bontango/WillFA7/docs/switch_matrix/07_Flash.md

== Flash ==

Williams ''Flash'' (1979), System 4. 48 belegte Schalter, Matrix 6 x 8.

=== Switch Matrix ===

{| class="wikitable"
!  !! Column 1<br />GRN-BRN !! Column 2<br />GRN-RED !! Column 3<br />GRN-ORN !! Column 4<br />GRN-YEL !! Column 5<br />GRN-BLK !! Column 6<br />GRN-BLU
|-
! Return 1<br />WHT-BRN
| 01 Plumb Bob Tilt || 09 Outside Upper Left Star Rollover || 17 Spinner || 25 Right Side Standup (Center) || 33 5-Bank, 2 Drop Target || 41 Left Kicker
|-
! Return 2<br />WHT-RED
| 02 Ball Roll Tilt || 10 Inside Upper Left Star Rollover || 18 Left Jet Bumper || 26 Right Side Standup (Lower) || 34 5-Bank, 3 Drop Target || 42 Right Kicker
|-
! Return 3<br />WHT-ORN
| 03 Credit Button || 11 Upper Left Standup || 19 Right Jet Bumper || 27 Eject Hole || 35 5-Bank, 4 Drop Target || 43 Left Special
|-
! Return 4<br />WHT-YEL
| 04 Right Coin Switch || 12 "1" Rollover || 20 Lower Jet Bumper || 28 3-Bank, Right Drop Target || 36 5-Bank, 5 Drop Target (Bottom) || 44 Left Flipper Return Lane Rollover
|-
! Return 5<br />WHT-GRN
| 05 Center Coin Switch || 13 "2" Rollover || 21 Upper Right Star Rollover || 29 3-Bank, Center Drop Target || 37 5-Bank Series || 45 Right Flipper Return Lane Rollover
|-
! Return 6<br />WHT-BLU
| 06 Left Coin Switch || 14 "3" Rollover || 22 Center Right Star Rollover || 30 3-Bank, Left Drop Target || 38 5-Bank Standup || 46 Right Special
|-
! Return 7<br />WHT-VIO
| 07 Slam Tilt || 15 "4" Rollover || 23 Lower Right Star Rollover || 31 3-Bank, Series || 39 Left Target || 47 Playfield Tilt
|-
! Return 8<br />WHT-GRY
| 08 High Score To Date Reset || 16 Top Right Standup || 24 Right Side Standup (Upper) || 32 5-Bank, 1 Drop Target (Top) || 40 Right Target || 48 Out Hole
|}

Columns 7 und 8 sind unbelegt (Switches 49-64).

=== Quelle ===

Schalterbelegung: Original-Handbuchblatt ''Flash'', Figure 11 "Switch Matrix". Das Blatt
deckt sich Schalter fuer Schalter mit der Pinitech-Datenbank; abweichend sind nur die
Schreibweisen (43/46 "Left/Right Special" statt "... Rollover", 44/45 mit "Lane",
48 "Out Hole"). Zusaetzlich gegengeprueft an der Dispatch-Tabelle des Spiel-ROMs
($60F1, 4 Bytes/Switch).

Kabelfarben: bei Williams System 3-7 einheitlich; belegt durch die Original-Handbuchblaetter von ''Contact'' (System 3, 1978, alle acht Spalten und Zeilen) und ''Laser Ball'' (System 6, 1979, Spalten 2-8), die identisch sind.
