bontango/WillFA7/docs/switch_matrix/08_Stellar_Wars.md

== Stellar Wars ==

Williams ''Stellar Wars'' (1979), System 4. 52 belegte Schalter, Matrix 7 x 8.

=== Switch Matrix ===

{| class="wikitable"
!  !! Column 1<br />GRN-BRN !! Column 2<br />GRN-RED !! Column 3<br />GRN-ORN !! Column 4<br />GRN-YEL !! Column 5<br />GRN-BLK !! Column 6<br />GRN-BLU !! Column 7<br />GRN-VIO
|-
! Return 1<br />WHT-BRN
| 01 Plumb Bob Tilt || 09 Outhole || 17 Left 3-Bank Center || 25 Left Spinner || 33 Right 3-Bank Right || 41 Right Special Rollover || 49 Playfield Tilt
|-
! Return 2<br />WHT-RED
| 02 Ball Roll Tilt || 10 Left Special Rollover || 18 Left 3-Bank Top || 26 "1" Rollover || 34 Right 3-Bank Series || 42 "S" Rollover || 50 4-Bank Left
|-
! Return 3<br />WHT-ORN
| 03 Credit Button || 11 "W" Rollover || 19 Left 3-Bank Series || 27 "2" Rollover || 35 Right 3-Bank Standup || 43 "R" Rollover || 51 4-Bank Left Center
|-
! Return 4<br />WHT-YEL
| 04 Right Coin Switch || 12 "A" Rollover || 20 Left 3-Bank Standup || 28 "3" Rollover || 36 Top Right Standup || 44 Right Kicker || 52 4-Bank Right Center
|-
! Return 5<br />WHT-GRN
| 05 Center Coin Switch || 13 Left Kicker || 21 Eject Hole || 29 "4" Rollover || 37 Right Spinner || 45 Top Left Jet Bumper || 53 4-Bank Right
|-
! Return 6<br />WHT-BLU
| 06 Left Coin Switch || 14 Bottom Left Jet Bumper || 22 Captive Ball Target || 30 Middle Right Standup || 38 Right Bull's-Eye Target || 46 Top Right Jet Bumper || 54 4-Bank Series
|-
! Return 7<br />WHT-VIO
| 07 Slam Tilt || 15 Not Used || 23 Lower Top Left Standup || 31 Right 3-Bank Left || 39 Not Used || 47 Bottom Right Jet Bumper || 55 Not Used
|-
! Return 8<br />WHT-GRY
| 08 High Score Reset || 16 Left 3-Bank Bottom || 24 Upper Top Left Standup || 32 Right 3-Bank Center || 40 Top Center Jet Bumper || 48 Center Standup || 56 Not Used
|}

Column 8 ist unbelegt (Switches 57-64).

=== Quelle ===

Schalterbelegung: Original-Handbuchblatt ''Stellar Wars'', Figure 11 "Switch Matrix".

Das Handbuchblatt korrigiert die Pinitech-Datenbank an einer funktional relevanten
Stelle: dort ist Switch 34 als "Top 3-Bank, Drop Target Series" **und** Switch 35
noch einmal als "Top 3-Bank Series" gefuehrt. Laut Handbuch ist 34 die Series und
35 der **Standup** der rechten 3-Bank. Damit sind beide 3-Banks symmetrisch aufgebaut:
links 16/17/18 Targets, 19 Series, 20 Standup - rechts 31/32/33 Targets, 34 Series,
35 Standup. Ausserdem heisst die Bank im Handbuch durchgaengig "Right 3-Bank", nicht
"Top 3-Bank".

Die Dispatch-Tabelle des Spiel-ROMs ($60DF, 4 Bytes/Switch) bestaetigt die Zuordnung
der Kabinettschalter 1-8 (acht verschiedene Sonder-Handler) und des Outhole 9 ($7E15);
fuer 34/35 ist sie nicht aussagekraeftig, weil in Stellar Wars fast alle
Spielfeldschalter ueber denselben Handler $7209 laufen und sich nur im Datenzeiger
unterscheiden.

Kabelfarben: bei Williams System 3-7 einheitlich; belegt durch die Original-Handbuchblaetter von ''Contact'' (System 3, 1978, alle acht Spalten und Zeilen) und ''Laser Ball'' (System 6, 1979, Spalten 2-8), die identisch sind.
