bontango/WillFA7/docs/switch_matrix/00_Hot_Tip.md

== Hot Tip ==

Williams ''Hot Tip'' (1977), System 3. 35 belegte Schalter, Matrix 5 x 8.

=== Switch Matrix ===

{| class="wikitable"
!  !! Column 1<br />GRN-BRN !! Column 2<br />GRN-RED !! Column 3<br />GRN-ORN !! Column 4<br />GRN-YEL !! Column 5<br />GRN-BLK
|-
! Return 1<br />WHT-BRN
| 01 Plumb Tilt || 09 Ball Return || 17 Right "Tip" Target || 25 Right "Hot" Target || 33 Bottom L.r.o. Special 1000
|-
! Return 2<br />WHT-RED
| 02 Ball Roll Tilt || 10 Playfield Tilt || 18 Center "Tip" Target || 26 Center "Hot" Target || 34 Inside Bottom L.r.o. 1000
|-
! Return 3<br />WHT-ORN
| 03 Credit Button || 11 Bottom R.r.o. Special 1000 || 19 Left "Tip" Target || 27 Left "Hot" Target || 35 L. Kicker 10 Pt. Sw.
|-
! Return 4<br />WHT-YEL
| 04 25 Cent Switch || 12 Inside Bottom R.r.o. 1000 || 20 Top Advance Bonus Target || 28 L. Top Stand-Up Sw. 10 || 36 Not Used
|-
! Return 5<br />WHT-GRN
| 05 10 Cent Switch || 13 R. Kicker 10 Pt. Sw. || 21 R. Top Stand-Up Sw. 10 || 29 L. Eject Sw. || 37 "Hot-Tip" Series
|-
! Return 6<br />WHT-BLU
| 06 5 Cent Switch || 14 R. Stand-Up Sw. 500 || 22 Top Eject Sw. || 30 Spinning Target Sw. || 38 Not Used
|-
! Return 7<br />WHT-VIO
| 07 Slam Tilt || 15 Captive Ball R.o. Sw. || 23 L. Top Stand-Up Sw. 10 || 31 Jet Bumper Sw. || 39 Not Used
|-
! Return 8<br />WHT-GRY
| 08 Not Used || 16 Captive Ball Target || 24 L. Top Rollover Sw. || 32 L. Stand-Up Sw. 500 || 40 Not Used
|}

=== Quelle ===

Schalterbelegung: Original-Handbuchblatt ''FIGURE 7 - SWITCH'' (Williams Electronics).

Kabelfarben: bei Williams System 3-7 einheitlich; belegt durch die Original-Handbuchblaetter von ''Contact'' (System 3, 1978, alle acht Spalten und Zeilen) und ''Laser Ball'' (System 6, 1979, Spalten 2-8), die identisch sind.
