bontango/WillFA7/docs/switch_matrix/01_Lucky_Seven.md

== Lucky Seven ==

Williams ''Lucky Seven'' (1978), System 3. 38 belegte Schalter, Matrix 7 x 8.

=== Switch Matrix ===

{| class="wikitable"
!  !! Column 1<br />GRN-BRN !! Column 2<br />GRN-RED !! Column 3<br />GRN-ORN !! Column 4<br />GRN-YEL !! Column 5<br />GRN-BLK !! Column 6<br />GRN-BLU !! Column 7<br />GRN-VIO
|-
! Return 1<br />WHT-BRN
| 01 Plumb Tilt || 09 Top Advance Bonus Target || 17 Both Drop Targets Down || 25 Not Used || 33 Left Jet Bumper || 41 Right Clover || 49 Not Used
|-
! Return 2<br />WHT-RED
| 02 Ball Roll Tilt || 10 Advance Bonus R.o. || 18 Bottom Advance Bonus Target || 26 Not Used || 34 Right Jet Bumper || 42 Not Used || 50 Center Clover
|-
! Return 3<br />WHT-ORN
| 03 Credit Button || 11 Left Reel R.o. || 19 Left Outside R.o. || 27 Left Clover || 35 Left Reel Target || 43 Not Used || 51 Not Used
|-
! Return 4<br />WHT-YEL
| 04 25 Cent Switch || 12 Center Reel R.o. || 20 Left Inside R.o. || 28 Three Sevens || 36 Right Kicker || 44 Not Used || 52 Not Used
|-
! Return 5<br />WHT-GRN
| 05 10 Cent Switch || 13 Right Reel R.o. || 21 Right Inside R.o. || 29 Three Horse-Shoes || 37 Top Left Stand Up || 45 Not Used || 53 Not Used
|-
! Return 6<br />WHT-BLU
| 06 5 Cent Switch || 14 Spinner || 22 Right Outside R.o. || 30 Three Diamonds || 38 Bottom Right Stand Up || 46 Not Used || 54 Not Used
|-
! Return 7<br />WHT-VIO
| 07 Slam Tilt || 15 Left Drop Target || 23 Outhole || 31 Playfield Tilt || 39 Center Reel Target || 47 Not Used || 55 Not Used
|-
! Return 8<br />WHT-GRY
| 08 Not Used || 16 Right Drop Target || 24 Left Kicker || 32 Not Used || 40 Right Reel Target || 48 Not Used || 56 Not Used
|}

=== Quelle ===

Schalterbelegung: Original-Handbuchblatt ''FIGURE 7 - SWITCH'' (Williams Electronics).

Kabelfarben: bei Williams System 3-7 einheitlich; belegt durch die Original-Handbuchblaetter von ''Contact'' (System 3, 1978, alle acht Spalten und Zeilen) und ''Laser Ball'' (System 6, 1979, Spalten 2-8), die identisch sind.
