bontango/WillFA7/docs/switch_matrix/02_World_Cup.md

== World Cup ==

Williams ''World Cup'' (1978), System 3. 37 belegte Schalter, Matrix 5 x 8.

=== Switch Matrix ===

{| class="wikitable"
!  !! Column 1<br />GRN-BRN !! Column 2<br />GRN-RED !! Column 3<br />GRN-ORN !! Column 4<br />GRN-YEL !! Column 5<br />GRN-BLK
|-
! Return 1<br />WHT-BRN
| 01 Plumb Tilt || 09 Left Eject || 17 Right Standup (10 Pt) || 25 Spinner || 33 Top Left Standup (10 Pt)
|-
! Return 2<br />WHT-RED
| 02 Ball Roll Tilt || 10 Left Standup (50 Pt) || 18 Right Special || 26 Super Ball Advance || 34 "S" Target
|-
! Return 3<br />WHT-ORN
| 03 Credit Button || 11 Left Special || 19 Right Standup (50 Pt) || 27 "R" Target || 35 Left Super Ball Advance
|-
! Return 4<br />WHT-YEL
| 04 25 Cent Switch || 12 Left Standup (10 Pt) || 20 Right Eject || 28 Right Super Ball Advance || 36 Left Inside Ball Advance
|-
! Return 5<br />WHT-GRN
| 05 10 Cent Switch || 13 Left Ball Thrower ("T") || 21 Ball Advance 1 || 29 Top Right Standup (10 Pt) || 37 Left Jet Bumper
|-
! Return 6<br />WHT-BLU
| 06 5 Cent Switch || 14 Outhole || 22 Ball Advance 2 || 30 Top Right Rollover (A/r) || 38 Right Jet Bumper
|-
! Return 7<br />WHT-VIO
| 07 Slam Tilt || 15 Playfield Tilt || 23 Ball Advance 3 || 31 Top Center Rollover || 39 Not Used
|-
! Return 8<br />WHT-GRY
| 08 Not Used || 16 Right Ball Thrower ("A") || 24 Ball Advance 4 || 32 Top Left Rollover (S/t) || 40 Not Used
|}

=== Quelle ===

Schalterbelegung: Original-Handbuchblatt ''WORLD CUP - SWITCH'' (Williams Electronics).

Kabelfarben: bei Williams System 3-7 einheitlich; belegt durch die Original-Handbuchblaetter von ''Contact'' (System 3, 1978, alle acht Spalten und Zeilen) und ''Laser Ball'' (System 6, 1979, Spalten 2-8), die identisch sind.
