bontango/WillFA7/docs/switch_matrix/03_Contact.md

== Contact ==

Williams ''Contact'' (1978), System 3. 39 belegte Schalter, Matrix 5 x 8.

=== Switch Matrix ===

{| class="wikitable"
!  !! Column 1<br />GRN-BRN !! Column 2<br />GRN-RED !! Column 3<br />GRN-ORN !! Column 4<br />GRN-YEL !! Column 5<br />GRN-BLK
|-
! Return 1<br />WHT-BRN
| 01 Plumb Bob Tilt || 09 "C" Rollover || 17 Right Special || 25 Left Center Standup || 33 Top Jet Bumper
|-
! Return 2<br />WHT-RED
| 02 Ball Roll Tilt || 10 "O" Eject || 18 Bottom Right Standup || 26 Left Eject || 34 Left Jet Bumper
|-
! Return 3<br />WHT-ORN
| 03 Credit Button || 11 "N" Rollover || 19 Right "T" || 27 Left Drop Target || 35 Right Jet Bumper
|-
! Return 4<br />WHT-YEL
| 04 Left Coin Switch || 12 Score Grn Value || 20 Outhole || 28 Left Center Drop Target || 36 "A" Target
|-
! Return 5<br />WHT-GRN
| 05 Center Coin Switch || 13 Top Right Target || 21 Left "T" || 29 Right Center Drop Target || 37 Moving Target
|-
! Return 6<br />WHT-BLU
| 06 Right Coin Switch || 14 Top Right Standup || 22 Bottom Left Standup || 30 Right Drop Target || 38 "C" Target
|-
! Return 7<br />WHT-VIO
| 07 Slam Tilt || 15 Bottom Right Target || 23 Left Special || 31 4 Drop Targets (Series) || 39 Inner Flipper
|-
! Return 8<br />WHT-GRY
| 08 Not Used || 16 Right Center Standup || 24 Playfield Tilt || 32 Lites Extra Ball Rollover || 40 Outer Flipper
|}

=== Quelle ===

Schalterbelegung: Original-Handbuchblatt ''Figure 9, CONTACT Switch Matrix'' (Williams Electronics).

Kabelfarben: bei Williams System 3-7 einheitlich; belegt durch die Original-Handbuchblaetter von ''Contact'' (System 3, 1978, alle acht Spalten und Zeilen) und ''Laser Ball'' (System 6, 1979, Spalten 2-8), die identisch sind.
