bontango/WillFA7/docs/switch_matrix/04_Disco_Fever.md

== Disco Fever ==

Williams ''Disco Fever'' (1978), System 3. 35 belegte Schalter, Matrix 5 x 8.

=== Switch Matrix ===

{| class="wikitable"
!  !! Column 1<br />GRN-BRN !! Column 2<br />GRN-RED !! Column 3<br />GRN-ORN !! Column 4<br />GRN-YEL !! Column 5<br />GRN-BLK
|-
! Return 1<br />WHT-BRN
| 01 Plumb Tilt || 09 Top Left Stand Up || 17 Right Jet Bumper || 25 Left Outside Rollover || 33 Left Jet Bumper
|-
! Return 2<br />WHT-RED
| 02 Ball Roll Tilt || 10 Top "A" Rollover || 18 Right Side Stand Up || 26 Spot "A" Or "B" Rollover || 34 Top Left Spot Disco
|-
! Return 3<br />WHT-ORN
| 03 Credit Button || 11 "F" Drop Target || 19 Right Outside Rollover || 27 Top "B" Rollover || 35 Turn Around Switch
|-
! Return 4<br />WHT-YEL
| 04 Left Coin Switch || 12 Top Right Stand Up || 20 "E" Drop Target || 28 Right Inside Rollover || 36 Not Used
|-
! Return 5<br />WHT-GRN
| 05 Center Coin Switch || 13 Top Right Advance Bonus || 21 Right Kicker || 29 "V" Drop Target || 37 Not Used
|-
! Return 6<br />WHT-BLU
| 06 Right Coin Switch || 14 Top Right Spot Disco || 22 Outhole || 30 Playfield Tilt || 38 "E" Drop Target
|-
! Return 7<br />WHT-VIO
| 07 Slam Tilt || 15 Bull's-Eye Target || 23 Left Kicker || 31 Not Used || 39 "R" Drop Target
|-
! Return 8<br />WHT-GRY
| 08 Not Used || 16 Mid Right Stand Up || 24 Left Inside Rollover || 32 Not Used || 40 "Er" Stand Up
|}

=== Quelle ===

Schalterbelegung: Original-Handbuchblatt ''Figure 9, DISCO FEVER Switch Matrix'' (Williams Electronics).

Kabelfarben: bei Williams System 3-7 einheitlich; belegt durch die Original-Handbuchblaetter von ''Contact'' (System 3, 1978, alle acht Spalten und Zeilen) und ''Laser Ball'' (System 6, 1979, Spalten 2-8), die identisch sind.
