bontango/WillFA7/docs/switch_matrix/09_Tri_Zone.md

== Tri Zone ==

Williams ''Tri Zone'' (1979), System 6. 35 belegte Schalter, Matrix 5 x 8.

=== Switch Matrix ===

{| class="wikitable"
!  !! Column 1<br />GRN-BRN !! Column 2<br />GRN-RED !! Column 3<br />GRN-ORN !! Column 4<br />GRN-YEL !! Column 5<br />GRN-BLK
|-
! Return 1<br />WHT-BRN
| 01 Plumb Bob Tilt || 09 Outhole || 17 Right Standup || 25 Eject Hole || 33 "N" Drop Target
|-
! Return 2<br />WHT-RED
| 02 Ball Roll Tilt || 10 Top A Rollover || 18 "R" Rollover || 26 Left Kicker || 34 Playfield Tilt
|-
! Return 3<br />WHT-ORN
| 03 Credit Button || 11 Top B Rollover || 19 "I" Rollover || 27 Left Inside Rollover || 35 "Z-O-N-E" Drop Targets Series
|-
! Return 4<br />WHT-YEL
| 04 Right Coin Switch || 12 Left Standup || 20 "E" Drop Target || 28 Left Outside Rollover || 36 Not Used
|-
! Return 5<br />WHT-GRN
| 05 Center Coin Switch || 13 Top Jet Bumper || 21 Lower Right Standup || 29 Bottom Left Standup || 37 Not Used
|-
! Return 6<br />WHT-BLU
| 06 Left Coin Switch || 14 Left Jet Bumper || 22 Right Outside Rollover || 30 "Z" Drop Target || 38 Not Used
|-
! Return 7<br />WHT-VIO
| 07 Slam Tilt || 15 Right Jet Bumper || 23 Right Inside Rollover || 31 Spinner || 39 Not Used
|-
! Return 8<br />WHT-GRY
| 08 High Score Reset || 16 "O" Drop Target || 24 Right Kicker || 32 "T" Rollover || 40 Not Used
|}

=== Quelle ===

Schalterbelegung: Pinitech Switch Matrix Database, https://www.pinitech.com/switch_database.php

Kabelfarben: bei Williams System 3-7 einheitlich; belegt durch die Original-Handbuchblaetter von ''Contact'' (System 3, 1978, alle acht Spalten und Zeilen) und ''Laser Ball'' (System 6, 1979, Spalten 2-8), die identisch sind.
