bontango/WillFA7/docs/switch_matrix/10_Time_Warp.md

== Time Warp ==

Williams ''Time Warp'' (1979), System 6. 44 belegte Schalter, Matrix 6 x 8.

=== Switch Matrix ===

{| class="wikitable"
!  !! Column 1<br />GRN-BRN !! Column 2<br />GRN-RED !! Column 3<br />GRN-ORN !! Column 4<br />GRN-YEL !! Column 5<br />GRN-BLK !! Column 6<br />GRN-BLU
|-
! Return 1<br />WHT-BRN
| 01 Plumb Bob Tilt || 09 Outhole || 17 Left Target || 25 5-Bank Drop Target #1 (Top) || 33 3-Bank Drop Target Left || 41 Right Kicker
|-
! Return 2<br />WHT-RED
| 02 Ball Roll Tilt || 10 Upper Right Standup || 18 Right Inside Rollover || 26 5-Bank Drop Target #2 || 34 3-Bank Drop Target Center || 42 Left Kicker
|-
! Return 3<br />WHT-ORN
| 03 Credit Button || 11 Upper Left Standup || 19 Left Top Jet Bumper || 27 5-Bank Drop Target #3 || 35 3-Bank Drop Target Right || 43 Playfield Tilt
|-
! Return 4<br />WHT-YEL
| 04 Right Coin Switch || 12 "A" Rollover || 20 Left Center Jet Bumper || 28 5-Bank Drop Target #4 || 36 3-Bank Drop Target Series || 44 Left Inside Rollover
|-
! Return 5<br />WHT-GRN
| 05 Center Coin Switch || 13 "B" Rollover || 21 Left Bottom Jet Bumper || 29 5-Bank Drop Target #5 (Bottom) || 37 3-Bank Standup || 45 Not Used
|-
! Return 6<br />WHT-BLU
| 06 Left Coin Switch || 14 "C" Rollover || 22 Right Center Jet Bumper || 30 5-Bank Drop Target Series || 38 Left Standup || 46 Not Used
|-
! Return 7<br />WHT-VIO
| 07 Slam Tilt || 15 Top Eject Hole || 23 Right Jet Bumper || 31 5-Bank Standup || 39 Right Outside Rollover || 47 Not Used
|-
! Return 8<br />WHT-GRY
| 08 High Score Reset || 16 Bull's-Eye Target || 24 Right Eject || 32 Right Standup || 40 Left Outside Rollover || 48 Not Used
|}

=== Quelle ===

Schalterbelegung: Pinitech Switch Matrix Database, https://www.pinitech.com/switch_database.php

Kabelfarben: bei Williams System 3-7 einheitlich; belegt durch die Original-Handbuchblaetter von ''Contact'' (System 3, 1978, alle acht Spalten und Zeilen) und ''Laser Ball'' (System 6, 1979, Spalten 2-8), die identisch sind.
