bontango/WillFA7/docs/switch_matrix/11_Gorgar.md

== Gorgar ==

Williams ''Gorgar'' (1979), System 6. 44 belegte Schalter, Matrix 6 x 8.

=== Switch Matrix ===

{| class="wikitable"
!  !! Column 1<br />GRN-BRN !! Column 2<br />GRN-RED !! Column 3<br />GRN-ORN !! Column 4<br />GRN-YEL !! Column 5<br />GRN-BLK !! Column 6<br />GRN-BLU
|-
! Return 1<br />WHT-BRN
| 01 Plumb Bob Tilt || 09 Outhole || 17 Upper Left Standup || 25 Middle Upper Standup || 33 "4" Target || 41 "G" Drop Target
|-
! Return 2<br />WHT-RED
| 02 Ball Roll Tilt || 10 Left Outside Rollover || 18 "G" Drop Target || 26 "A" Rollover || 34 Right Outside Rollover || 42 "A" Drop Target
|-
! Return 3<br />WHT-ORN
| 03 Credit Button || 11 "D" Rollover || 19 "O" Drop Target || 27 "B" Rollover || 35 "E" Rollover || 43 "R" Drop Target
|-
! Return 4<br />WHT-YEL
| 04 Right Coin Switch || 12 Left Kicker || 20 "R" Drop Target || 28 "C" Rollover || 36 Right Kicker || 44 "G-A-R" Drop Targets Series
|-
! Return 5<br />WHT-GRN
| 05 Center Coin Switch || 13 Lower Left Standup || 21 "G-O-R" Drop Targets Series || 29 Playfield Tilt || 37 Left Jet Bumper || 45 Not Used
|-
! Return 6<br />WHT-BLU
| 06 Left Coin Switch || 14 "1" Target || 22 "G-O-R" Drop Targets Standup || 30 Spinner || 38 Top Jet Bu Mper || 46 Not Used
|-
! Return 7<br />WHT-VIO
| 07 Slam Tilt || 15 Eject Hole || 23 Magnet Switch || 31 "2" Target || 39 Bottom Jet Bumper || 47 Not Used
|-
! Return 8<br />WHT-GRY
| 08 High Score Reset || 16 Middle Left Standup || 24 Middle Lower Standup || 32 "3" Target || 40 "G-A-R" Drop Targets Standup || 48 Not Used
|}

=== Quelle ===

Schalterbelegung: Pinitech Switch Matrix Database, https://www.pinitech.com/switch_database.php

Kabelfarben: bei Williams System 3-7 einheitlich; belegt durch die Original-Handbuchblaetter von ''Contact'' (System 3, 1978, alle acht Spalten und Zeilen) und ''Laser Ball'' (System 6, 1979, Spalten 2-8), die identisch sind.
