bontango/WillFA7/docs/switch_matrix/12_Laser_Ball.md

== Laser Ball ==

Williams ''Laser Ball'' (1979), System 6. 58 belegte Schalter, Matrix 8 x 8.

=== Switch Matrix ===

{| class="wikitable"
!  !! Column 1<br />GRN-BRN !! Column 2<br />GRN-RED !! Column 3<br />GRN-ORN !! Column 4<br />GRN-YEL !! Column 5<br />GRN-BLK !! Column 6<br />GRN-BLU !! Column 7<br />GRN-VIO !! Column 8<br />GRN-GRY
|-
! Return 1<br />WHT-BRN
| 01 Plumb Bob Tilt || 09 Outhole || 17 Left Spinner || 25 Lower Top Left Standup || 33 Upper Right Standup || 41 Right Shooter || 49 Playfield Tilt || 57 Star 8 Rollover
|-
! Return 2<br />WHT-RED
| 02 Ball Roll Tilt || 10 Left Shooter || 18 Bull's-Eye Target || 26 Upper Top Left Standup || 34 "B" Drop Target || 42 Right Special || 50 Star 1 Rollover || 58 Star 9 Rollover
|-
! Return 3<br />WHT-ORN
| 03 Credit Button || 11 Left Special || 19 "L" Drop Target || 27 "1" and "2" Rollover || 35 "A" Drop Target || 43 Right Inside Rollover || 51 Star 2 Rollover || 59 Star 10 Rollover
|-
! Return 4<br />WHT-YEL
| 04 Right Coin Switch || 12 Left Inside Rollover || 20 "A" Drop Target || 28 "3" and "4" Rollover || 36 "L" Drop Target || 44 Right Kicker || 52 Star 3 Rollover || 60 Not Used
|-
! Return 5<br />WHT-GRN
| 05 Center Coin Switch || 13 Left Kicker || 21 "S" Drop Target || 29 "5" and "6" Rollover || 37 "L" Drop Target (Bottom) || 45 Left Jet Bumper || 53 Star 4 Rollover || 61 Not Used
|-
! Return 6<br />WHT-BLU
| 06 Left Coin Switch || 14 Middle Left Side Standup || 22 "E" Drop Target || 30 "7" and "8" Rollover || 38 B-A-L-L Drop Target Series || 46 Right Jet Bumper || 54 Star 5 Rollover || 62 Not Used
|-
! Return 7<br />WHT-VIO
| 07 Slam Tilt || 15 Not Used || 23 "R" Drop Target || 31 "9" and "10" Rollover || 39 B-A-L-L Drop Target Standup || 47 Center Jet Bumper || 55 Star 6 Rollover || 63 Not Used
|-
! Return 8<br />WHT-GRY
| 08 High Score Reset || 16 Left Side Target || 24 L-A-S-E-R Drop Target Series || 32 Eject Hole || 40 Right Spinner || 48 "S-E-R" Drop Target Standup || 56 Star 7 Rollover || 64 Not Used
|}

=== Steckerbelegung ===

Aus dem Original-Handbuchblatt. Column 1 (Schalter 01-08) ist die Cabinet-Spalte und dort nicht dargestellt.

{| class="wikitable"
! Leitung !! Farbe !! Driver Board !! Playfield
|-
| Column 2 || GRN-RED || 2P2-8 || 8P1-1
|-
| Column 3 || GRN-ORN || 2P2-7 || 8P1-2
|-
| Column 4 || GRN-YEL || 2P2-6 || 8P1-3
|-
| Column 5 || GRN-BLK || 2P2-5 || 8P1-4
|-
| Column 6 || GRN-BLU || 2P2-3 || 8P1-5
|-
| Column 7 || GRN-VIO || 2P2-2 || 8P1-6
|-
| Column 8 || GRN-GRY || 2P2-1 || 8P1-7
|-
| Return 1 || WHT-BRN || 2P3-9 || 8J1-8
|-
| Return 2 || WHT-RED || 2P3-8 || 8J1-9
|-
| Return 3 || WHT-ORN || 2P3-7 || 8J1-10
|-
| Return 4 || WHT-YEL || 2P3-6 || 8J1-11
|-
| Return 5 || WHT-GRN || 2P3-5 || 8J1-12
|-
| Return 6 || WHT-BLU || 2P3-4 || 8J1-13
|-
| Return 7 || WHT-VIO || 2P3-3 || 8J1-14
|-
| Return 8 || WHT-GRY || 2P3-1 || 8J1-15
|}

=== Quelle ===

Schalterbelegung: Original-Handbuchblatt ''LASER BALL - Playfield Switch Wiring Diagram'' (Williams Electronics).

'''Hinweis:''' Das Blatt zeigt nur die Playfield-Spalten (Column 2-8, Schalter 09-59). Die Cabinet-Spalte (Column 1, Schalter 01-08) ist dort nicht enthalten und wurde nach der bei Williams System 3-7 einheitlichen Belegung ergaenzt - bitte vor der Uebernahme gegen ein Handbuch pruefen.

Kabelfarben: bei Williams System 3-7 einheitlich; belegt durch die Original-Handbuchblaetter von ''Contact'' (System 3, 1978, alle acht Spalten und Zeilen) und ''Laser Ball'' (System 6, 1979, Spalten 2-8), die identisch sind.
