bontango/WillFA7/docs/switch_matrix/13_Firepower.md

== Firepower ==

Williams ''Firepower'' (1980), System 6. 53 belegte Schalter, Matrix 8 x 8.

=== Switch Matrix ===

{| class="wikitable"
!  !! Column 1<br />GRN-BRN !! Column 2<br />GRN-RED !! Column 3<br />GRN-ORN !! Column 4<br />GRN-YEL !! Column 5<br />GRN-BLK !! Column 6<br />GRN-BLU !! Column 7<br />GRN-VIO !! Column 8<br />GRN-GRY
|-
! Return 1<br />WHT-BRN
| 01 Plumb Bob Tilt || 09 Outhole || 17 "1" Target || 25 Bottom Left Jet Bumper || 33 "I" Rollover || 41 Bottom "Power" Targets || 49 Center Middle Left Standup || 57 Right Ball Ramp
|-
! Return 2<br />WHT-RED
| 02 Ball Roll Tilt || 10 Left Outside Rollover || 18 "2" Target || 26 Top Left Jet Bumper || 34 "R" Rollover || 42 Right Kicker || 50 Lower Middle Left Standup || 58 Center Ball Ramp
|-
! Return 3<br />WHT-ORN
| 03 Credit Button || 11 Left Inside Rollover || 19 "3" Target || 27 Top Right Jet Bumper || 35 "E" Rollover || 43 Right Inside Rollover || 51 Left Ball Ramp || 59 Not Used
|-
! Return 4<br />WHT-YEL
| 04 Right Coin Switch || 12 Left Kicker || 20 Not Used || 28 Bottom Right Jet Bumper || 36 Upper Right Eject Hole || 44 Right Outside Rollover || 52 Not Used || 60 Not Used
|-
! Return 5<br />WHT-GRN
| 05 Center Coin Switch || 13 Left Eject Hole || 21 "4" Target || 29 Top Center Target || 37 Lower Top Right Standup || 45 Right Flipper Lane Change Switch || 53 Left Eject Rollover || 61 Not Used
|-
! Return 6<br />WHT-BLU
| 06 Left Coin Switch || 14 Upper Middle Left Standup || 22 "5" Target || 30 Right Eject Hole || 38 Middle Right Standup || 46 Ball Shooter || 54 Right Eject Rollover || 62 Not Used
|-
! Return 7<br />WHT-VIO
| 07 Slam Tilt || 15 Spinner || 23 "6" Target || 31 Upper Top Right Standup || 39 Top "Power" Target || 47 Playfield Tilt || 55 Not Used || 63 Not Used
|-
! Return 8<br />WHT-GRY
| 08 High Score Reset || 16 Top Left Standup || 24 Not Used || 32 "F" Rollover || 40 Middle "Power" Target || 48 Lower Right Standup || 56 Not Used || 64 Not Used
|}

=== Quelle ===

Schalterbelegung: Pinitech Switch Matrix Database, https://www.pinitech.com/switch_database.php

Kabelfarben: bei Williams System 3-7 einheitlich; belegt durch die Original-Handbuchblaetter von ''Contact'' (System 3, 1978, alle acht Spalten und Zeilen) und ''Laser Ball'' (System 6, 1979, Spalten 2-8), die identisch sind.
