bontango/WillFA7/docs/switch_matrix/14_Blackout.md

== Blackout ==

Williams ''Blackout'' (1980), System 6. 43 belegte Schalter, Matrix 6 x 8.

=== Switch Matrix ===

{| class="wikitable"
!  !! Column 1<br />GRN-BRN !! Column 2<br />GRN-RED !! Column 3<br />GRN-ORN !! Column 4<br />GRN-YEL !! Column 5<br />GRN-BLK !! Column 6<br />GRN-BLU
|-
! Return 1<br />WHT-BRN
| 01 Plumb Bob Tilt || 09 Outhole || 17 Not Used || 25 Center 3 Bank Left || 33 Top 3 Bank Left || 41 Right Outside Rollover
|-
! Return 2<br />WHT-RED
| 02 Ball Roll Tilt || 10 Left Outside Rollover || 18 Left Spinner || 26 Center 3 Bank Center || 34 Top 3 Bank Center || 42 Right Inside Rollover
|-
! Return 3<br />WHT-ORN
| 03 Credit Button || 11 Green Target #1 Bottom || 19 Left Spinner Standup || 27 Center 3 Bank Right || 35 Top 3 Bank Right || 43 Right Kicker
|-
! Return 4<br />WHT-YEL
| 04 Right Coin Switch || 12 Green Target #2 || 20 Upper Left Target || 28 Center 3 Bank Series || 36 Top 3 Bank Series || 44 Left Kicker
|-
! Return 5<br />WHT-GRN
| 05 Center Coin Switch || 13 Green Target #3 || 21 Right Jet Bumper || 29 1 Rollover || 37 Upper Right Spinner || 45 Left Inside Rollover
|-
! Return 6<br />WHT-BLU
| 06 Left Coin Switch || 14 Green Target #4 || 22 Left Jet Bumper || 30 2 Rollover || 38 Middle Right Standup || 46 Right Flipper Lane Change Switch
|-
! Return 7<br />WHT-VIO
| 07 Slam Tilt || 15 Green Target #5 Top || 23 Bottom Jet Bumper || 31 3 Rollover || 39 Middle Right Spinner || 47 Not Used
|-
! Return 8<br />WHT-GRY
| 08 High Score Reset || 16 Not Used || 24 Not Used || 32 Playfield Tilt || 40 Eject Hole || 48 Not Used
|}

=== Quelle ===

Schalterbelegung: Pinitech Switch Matrix Database, https://www.pinitech.com/switch_database.php

Kabelfarben: bei Williams System 3-7 einheitlich; belegt durch die Original-Handbuchblaetter von ''Contact'' (System 3, 1978, alle acht Spalten und Zeilen) und ''Laser Ball'' (System 6, 1979, Spalten 2-8), die identisch sind.
