bontango/WillFA7/docs/switch_matrix/15_Scorpion.md

== Scorpion ==

Williams ''Scorpion'' (1980), System 6. 57 belegte Schalter, Matrix 8 x 8.

=== Switch Matrix ===

{| class="wikitable"
!  !! Column 1<br />GRN-BRN !! Column 2<br />GRN-RED !! Column 3<br />GRN-ORN !! Column 4<br />GRN-YEL !! Column 5<br />GRN-BLK !! Column 6<br />GRN-BLU !! Column 7<br />GRN-VIO !! Column 8<br />GRN-GRY
|-
! Return 1<br />WHT-BRN
| 01 Plumb Bob Tilt || 09 Ball Ramp Thrower || 17 Right Flipper Lane Change Switch || 25 Top Left 3-Bank, Left Drop Target || 33 5-Bank #1 Drop Target (Left) || 41 Advance Left Lower Bull's-Eye Target || 49 Upper Right Return Lane || 57 Lower Right Standup
|-
! Return 2<br />WHT-RED
| 02 Ball Roll Tilt || 10 Ball Ramp || 18 Left Center Rollover || 26 Top Left 3-Bank, Center Drop Target || 34 5-Bank #2 Drop Target || 42 Advance Right Lower Bull's-Eye Target || 50 Upper Left Flipper Standup || 58 Not Used
|-
! Return 3<br />WHT-ORN
| 03 Credit Button || 11 Left Eject Hole || 19 Left Inside Rollover || 27 Top Left 3-Bank, Right Drop Target || 35 5-Bank #3 Drop Target || 43 "1" Target || 51 Top Left 3-Bank Standup || 59 Not Used
|-
! Return 4<br />WHT-YEL
| 04 Right Coin Switch || 12 Right Eject Hole || 20 Right Inside Rollover || 28 Top Right 3-Bank, Left Drop Target || 36 5-Bank #4 Drop Target || 44 "2" Target || 52 Top Right 3-Bank Standup || 60 Not Used
|-
! Return 5<br />WHT-GRN
| 05 Center Coin Switch || 13 Playfield Tilt || 21 Right Center Rollover || 29 Top Right 3-Bank, Center Drop Target || 37 5-Bank #5 Drop Target (Right) || 45 "3" Target || 53 Lower Top Center Standup || 61 Not Used
|-
! Return 6<br />WHT-BLU
| 06 Left Coin Switch || 14 Left Outside Rollover || 22 Right Jet Bumper || 30 Top Right 3-Bank, Right Drop Target || 38 5-Bank Drop Targets Series || 46 "4" Rollover || 54 5-Bank Standup || 62 Not Used
|-
! Return 7<br />WHT-VIO
| 07 Slam Switch || 15 Right Outside Rollover || 23 Bottom Jet Bumper || 31 Top 3-Banks Drop Target Series || 39 Left Kicker || 47 "5" Rollover || 55 Upper Top Center Standup || 63 Not Used
|-
! Return 8<br />WHT-GRY
| 08 High Score Reset || 16 Outhole || 24 Top Jet Bumper || 32 Spinner || 40 Right Kicker || 48 "6" Rollover || 56 Top Right Standup || 64 Not Used
|}

=== Quelle ===

Schalterbelegung: Original-Handbuchblatt ''Figure 5, Switch Matrix'' (Williams Electronics).

Kabelfarben: bei Williams System 3-7 einheitlich; belegt durch die Original-Handbuchblaetter von ''Contact'' (System 3, 1978, alle acht Spalten und Zeilen) und ''Laser Ball'' (System 6, 1979, Spalten 2-8), die identisch sind.
