bontango/WillFA7/docs/switch_matrix/16_Algar.md

== Algar ==

Williams ''Algar'' (1980), System 6A. 53 belegte Schalter, Matrix 7 x 8.

=== Switch Matrix ===

{| class="wikitable"
!  !! Column 1<br />GRN-BRN !! Column 2<br />GRN-RED !! Column 3<br />GRN-ORN !! Column 4<br />GRN-YEL !! Column 5<br />GRN-BLK !! Column 6<br />GRN-BLU !! Column 7<br />GRN-VIO
|-
! Return 1<br />WHT-BRN
| 01 Plumb Bob Tilt || 09 Outhole || 17 Left 3-Bank Drop Target Series || 25 "O" Rollover || 33 Right Chamber Target || 41 Center 3-Bank, Right Target || 49 Right Jet Bumper
|-
! Return 2<br />WHT-RED
| 02 Ball Roll Tilt || 10 Left Kicker || 18 Left 3-Bank Standup || 26 Eject Hole || 34 Middle Right Standup || 42 Center 3-Bank, Drop Target Series || 50 Right Flipper Lane Change Feature
|-
! Return 3<br />WHT-ORN
| 03 Credit Button || 11 Left Inside Rollover || 19 Ball Shooter || 27 "R" Rollover || 35 Right Return Gate Rollover || 43 Center 3-Bank Standup || 51 Playfield Tilt
|-
! Return 4<br />WHT-YEL
| 04 Right Coin Switch || 12 Left Outlane || 20 Upper Left Standup, Lower || 28 "A" Rollover || 36 Right Outside Kicker || 44 Loop Gate || 52 Upper Right Center Standup
|-
! Return 5<br />WHT-GRN
| 05 Center Coin Switch || 13 Left Loop Lane Rollover || 21 Upper Left Standup, Upper || 29 Right Spinner || 37 Right Outlane || 45 Center Left Standup || 53 Upper Right Lower Standup
|-
! Return 6<br />WHT-BLU
| 06 Left Coin Switch || 14 Left 3-Bank, Left Drop Target || 22 Left Spinner || 30 Upper Right Standup, Top || 38 Right Inside Kicker || 46 Center Right Standup || 54 Not Used
|-
! Return 7<br />WHT-VIO
| 07 Slam Tilt || 15 Left 3-Bank, Center Drop Target || 23 Top Left Standup || 31 Left Chamber Target || 39 Center 3-Bank, Left Target || 47 Left Jet Bumper || 55 Not Used
|-
! Return 8<br />WHT-GRY
| 08 High Score Reset || 16 Left 3-Bank, Right Drop Target || 24 "K" Rollover || 32 Center Chamber Target || 40 Center 3-Bank, Center Target || 48 Center Jet Bumper || 56 Not Used
|}

=== Quelle ===

Schalterbelegung: Pinitech Switch Matrix Database, https://www.pinitech.com/switch_database.php

Kabelfarben: bei Williams System 3-7 einheitlich; belegt durch die Original-Handbuchblaetter von ''Contact'' (System 3, 1978, alle acht Spalten und Zeilen) und ''Laser Ball'' (System 6, 1979, Spalten 2-8), die identisch sind.
