bontango/WillFA7/docs/switch_matrix/17_Alien_Poker.md

== Alien Poker ==

Williams ''Alien Poker'' (1980), System 6A. 43 belegte Schalter, Matrix 6 x 8.

=== Switch Matrix ===

{| class="wikitable"
!  !! Column 1<br />GRN-BRN !! Column 2<br />GRN-RED !! Column 3<br />GRN-ORN !! Column 4<br />GRN-YEL !! Column 5<br />GRN-BLK !! Column 6<br />GRN-BLU
|-
! Return 1<br />WHT-BRN
| 01 Plumb Bob Tilt || 09 Outhole || 17 Spinner || 25 King of Diamonds Rollover || 33 Lower Right Standup || 41 5 Bank Standup
|-
! Return 2<br />WHT-RED
| 02 Ball Roll Tilt || 10 "A" Drop Target || 18 "K" Drop Target || 26 "Q" Drop Target || 34 "J" Drop Target || 42 "10" Drop Target
|-
! Return 3<br />WHT-ORN
| 03 Credit Button || 11 Left Special || 19 Lower Top Standup || 27 King of Spades Rollover || 35 Center Jet Bumper || 43 Right Flipper Lane Change Switch
|-
! Return 4<br />WHT-YEL
| 04 Right Coin Switch || 12 Left Inside Rollover || 20 Top Joker Target || 28 Top Right Standup || 36 Left Jet Bumper || 44 Not Used
|-
! Return 5<br />WHT-GRN
| 05 Center Coin Switch || 13 Left Kicker || 21 Top Standup || 29 Heart Ace Eject Hole || 37 Right Jet Bumper || 45 Not Used
|-
! Return 6<br />WHT-BLU
| 06 Left Coin Switch || 14 Lower Left Joker Target || 22 Club Ace Eject Hole || 30 Right Joker Target || 38 Bottom Jet Bumper || 46 Not Used
|-
! Return 7<br />WHT-VIO
| 07 Slam Tilt || 15 Spade Ace Eject Hole || 23 King of Hearts Rollover || 31 Playfield Tilt || 39 Left Center Standup || 47 Not Used
|-
! Return 8<br />WHT-GRY
| 08 High Score Reset || 16 Middle Left Joker Target || 24 King of Clubs Rollover || 32 Right Special || 40 Right Center Standup || 48 Not Used
|}

=== Quelle ===

Schalterbelegung: Pinitech Switch Matrix Database, https://www.pinitech.com/switch_database.php

Kabelfarben: bei Williams System 3-7 einheitlich; belegt durch die Original-Handbuchblaetter von ''Contact'' (System 3, 1978, alle acht Spalten und Zeilen) und ''Laser Ball'' (System 6, 1979, Spalten 2-8), die identisch sind.
