bontango/WillFA7/docs/switch_matrix/18_Black_Knight.md

== Black Knight ==

Williams ''Black Knight'' (1980), System 7. 43 belegte Schalter, Matrix 6 x 8.

=== Switch Matrix ===

{| class="wikitable"
!  !! Column 1<br />GRN-BRN !! Column 2<br />GRN-RED !! Column 3<br />GRN-ORN !! Column 4<br />GRN-YEL !! Column 5<br />GRN-BLK !! Column 6<br />GRN-BLU
|-
! Return 1<br />WHT-BRN
| 01 Plumb Bob Tilt || 09 Right Magnet Button || 17 Right Ball Ramp || 25 Lower Left 3-Bank, Lower Target || 33 Top Left 3-Bank, Lower Target || 41 Lockup Trough, Bottom
|-
! Return 2<br />WHT-RED
| 02 Ball Roll Tilt || 10 Left Magnet Button || 18 Center Ball Ramp || 26 Lower Left 3-Bank, Center Target || 34 Top Left 3-Bank, Center Target || 42 Lockup Trough, Center
|-
! Return 3<br />WHT-ORN
| 03 Credit Button || 11 Left Outlane || 19 Left Ball Ramp || 27 Lower Left 3-Bank, Upper Target || 35 Top Left 3-Bank, Upper Target || 43 Lockup Trough, Top
|-
! Return 4<br />WHT-YEL
| 04 Right Coin Switch || 12 Right Outlane || 20 Outhole || 28 Not Used || 36 Jet Bumper || 44 Left Ramp Rollover
|-
! Return 5<br />WHT-GRN
| 05 Center Coin Switch || 13 Spinner || 21 Left Kicker || 29 Lower Right 3-Bank, Right Target || 37 Top Right 3-Bank, Lower Target || 45 Ballshooter Trough
|-
! Return 6<br />WHT-BLU
| 06 Left Coin Switch || 14 Right Ramp Rollunder || 22 Right Kicker || 30 Lower Right 3-Bank, Center Target || 38 Top Right 3-Bank, Center Target || 46 Playfield Tilt
|-
! Return 7<br />WHT-VIO
| 07 Slam Tilt || 15 Right Inside Rollover || 23 Turnaround || 31 Lower Right 3-Bank, Left Target || 39 Top Right 3-Bank, Upper Target || 47 Not Used
|-
! Return 8<br />WHT-GRY
| 08 High Score Reset || 16 Left Inside Rollover || 24 Lower Playfield Eject Hole || 32 Not Used || 40 Not Used || 48 Not Used
|}

=== Quelle ===

Schalterbelegung: Pinitech Switch Matrix Database, https://www.pinitech.com/switch_database.php

Kabelfarben: bei Williams System 3-7 einheitlich; belegt durch die Original-Handbuchblaetter von ''Contact'' (System 3, 1978, alle acht Spalten und Zeilen) und ''Laser Ball'' (System 6, 1979, Spalten 2-8), die identisch sind.
