bontango/WillFA7/docs/switch_matrix/19_Jungle_Lord.md

== Jungle Lord ==

Williams ''Jungle Lord'' (1981), System 7. 48 belegte Schalter, Matrix 7 x 8.

=== Switch Matrix ===

{| class="wikitable"
!  !! Column 1<br />GRN-BRN !! Column 2<br />GRN-RED !! Column 3<br />GRN-ORN !! Column 4<br />GRN-YEL !! Column 5<br />GRN-BLK !! Column 6<br />GRN-BLU !! Column 7<br />GRN-VIO
|-
! Return 1<br />WHT-BRN
| 01 Plumb Bob Tilt || 09 Right Ball Ramp || 17 1 Target || 25 Right 3-Bank, Lower Drop Target || 33 5-Bank, #1 Drop Target (Left) || 41 Playfield Tilt || 49 Right Magnet Button
|-
! Return 2<br />WHT-RED
| 02 Ball Roll Tilt || 10 Left Ball Ramp || 18 2 Target || 26 Right 3-Bank, Center Drop Target || 34 5-Bank, #2 Drop Target || 42 Outhole || 50 Left Magnet Button
|-
! Return 3<br />WHT-ORN
| 03 Credit Button || 11 Not Used || 19 3 Target || 27 Right 3-Bank, Upper Drop Target || 35 5-Bank, #3 Drop Target || 43 Ballshooter Trough || 51 Not Used
|-
! Return 4<br />WHT-YEL
| 04 Right Coin Switch || 12 Left Kicker || 20 4 Rollover || 28 Right Kicker || 36 5-Bank, #4 Drop Target || 44 Playfield Entry || 52 Not Used
|-
! Return 5<br />WHT-GRN
| 05 Center Coin Switch || 13 "L" Rollover || 21 5 Rollover || 29 Left 3-Bank, Lower Drop Target || 37 5-Bank, #5 Drop Target || 45 Upper Left Standup || 53 Not Used
|-
! Return 6<br />WHT-BLU
| 06 Left Coin Switch || 14 "O" Rollover || 22 Left Drain Lane || 30 Left 3-Bank, Center Drop Target || 38 Upper Eject Hole || 46 Left Standup || 54 Not Used
|-
! Return 7<br />WHT-VIO
| 07 Slam Tilt || 15 "R" Rollover || 23 Right Drain Lane || 31 Left 3-Bank, Upper Drop Target || 39 Lower Eject Hole || 47 Right Standup || 55 Not Used
|-
! Return 8<br />WHT-GRY
| 08 High Score Reset || 16 "D" Rollover || 24 Turnaround, Lower Rollover || 32 Turnaround, Upper Rollover || 40 Upper Kicker || 48 Not Used || 56 Not Used
|}

=== Quelle ===

Schalterbelegung: Pinitech Switch Matrix Database, https://www.pinitech.com/switch_database.php

Kabelfarben: bei Williams System 3-7 einheitlich; belegt durch die Original-Handbuchblaetter von ''Contact'' (System 3, 1978, alle acht Spalten und Zeilen) und ''Laser Ball'' (System 6, 1979, Spalten 2-8), die identisch sind.
