bontango/WillFA7/docs/switch_matrix/20_Pharaoh.md

== Pharaoh ==

Williams ''Pharaoh'' (1981), System 7. 41 belegte Schalter, Matrix 6 x 8.

=== Switch Matrix ===

{| class="wikitable"
!  !! Column 1<br />GRN-BRN !! Column 2<br />GRN-RED !! Column 3<br />GRN-ORN !! Column 4<br />GRN-YEL !! Column 5<br />GRN-BLK !! Column 6<br />GRN-BLU
|-
! Return 1<br />WHT-BRN
| 01 Plumb Bob Tilt || 09 Left Magnet Button || 17 Upper Left 3-Bank, Bottom Target || 25 Lower Center 3-Bank, Bottom Target || 33 Slaves Tomb Shooter || 41 Captive Ball
|-
! Return 2<br />WHT-RED
| 02 Ball Roll Tilt || 10 Right Magnet Button || 18 Upper Left 3-Bank, Center Target || 26 Lower Center 3-Bank, Center Target || 34 Upper Eject Hole || 42 Playfield Tilt
|-
! Return 3<br />WHT-ORN
| 03 Credit Button || 11 Not Used || 19 Upper Left 3-Bank, Top Target || 27 Lower Center 3-Bank, Top Target || 35 Lower Eject Hole || 43 Hidden Tomb Shooter
|-
! Return 4<br />WHT-YEL
| 04 Right Coin Switch || 12 Not Used || 20 Upper Kicker || 28 Upper Bull's-Eye Target || 36 Outhole || 44 Right Kicker
|-
! Return 5<br />WHT-GRN
| 05 Center Coin Switch || 13 Left Inside Rollover || 21 Upper Center 3-Bank, Left Target || 29 Lower Right 3-Bank, Top Target || 37 Not Used || 45 Not Used
|-
! Return 6<br />WHT-BLU
| 06 Left Coin Switch || 14 Right Inside Rollover || 22 Upper Center 3-Bank, Center Target || 30 Lower Right 3-Bank, Center Target || 38 Ball Ramp Left Switch || 46 Not Used
|-
! Return 7<br />WHT-VIO
| 07 Slam Tilt || 15 Left ? Lane Rollover || 23 Upper Center 3-Bank, Right Target || 31 Lower Right 3-Bank, Bottom Target || 39 Ball Ramp Right Switch || 47 Not Used
|-
! Return 8<br />WHT-GRY
| 08 High Score Reset || 16 Right ? Lane Rollover || 24 Left Kicker || 32 Lower Bull's-Eye Target || 40 Ballshooter Trough || 48 Not Used
|}

=== Quelle ===

Schalterbelegung: Pinitech Switch Matrix Database, https://www.pinitech.com/switch_database.php

Kabelfarben: bei Williams System 3-7 einheitlich; belegt durch die Original-Handbuchblaetter von ''Contact'' (System 3, 1978, alle acht Spalten und Zeilen) und ''Laser Ball'' (System 6, 1979, Spalten 2-8), die identisch sind.
