bontango/WillFA7/docs/switch_matrix/21_Solar_Fire.md

== Solar Fire ==

Williams ''Solar Fire'' (1981), System 7. 43 belegte Schalter, Matrix 6 x 8.

=== Switch Matrix ===

{| class="wikitable"
!  !! Column 1<br />GRN-BRN !! Column 2<br />GRN-RED !! Column 3<br />GRN-ORN !! Column 4<br />GRN-YEL !! Column 5<br />GRN-BLK !! Column 6<br />GRN-BLU
|-
! Return 1<br />WHT-BRN
| 01 Plumb Bob Tilt || 09 Left Magnet Button || 17 Top Eject Hole || 25 Right Bull's-Eye Target || 33 Top 3-Bank, Bottom Target || 41 Solar Ramp Target
|-
! Return 2<br />WHT-RED
| 02 Ball Roll Tilt || 10 Right Magnet Button || 18 Bottom Right Eject Hole || 26 Right Ramp Rollunder || 34 Top 3-Bank, Middle Target || 42 Solar Gun
|-
! Return 3<br />WHT-ORN
| 03 Credit Button || 11 Left Kicker || 19 Bottom Left Eject Hole || 27 Bottom Left 3-Bank, Bottom Target || 35 Top 3-Bank, Top Target || 43 Playfield Tilt
|-
! Return 4<br />WHT-YEL
| 04 Right Coin Switch || 12 Right Kicker || 20 Outhole || 28 Bottom Left 3-Bank, Middle Target || 36 4-Bank "1" (Left) Target || 44 Not Used
|-
! Return 5<br />WHT-GRN
| 05 Center Coin Switch || 13 Left Outlane || 21 Ball Ramp Right Switch || 29 Bottom Left 3-Bank, Top Target || 37 4-Bank "2" Target || 45 Not Used
|-
! Return 6<br />WHT-BLU
| 06 Left Coin Switch || 14 Right Outlane || 22 Ball Ramp Center Switch || 30 Bottom Right 3-Bank, Top Target || 38 4-Bank "3" Target || 46 Not Used
|-
! Return 7<br />WHT-VIO
| 07 Slam Tilt || 15 Left Inside Rollover || 23 Ball Ramp Left Switch || 31 Bottom Right 3-Bank, Middle Target || 39 4-Bank "4" (Right) Target || 47 Not Used
|-
! Return 8<br />WHT-GRY
| 08 High Score Reset || 16 Right Inside Rollover || 24 Ballshooter Trough || 32 Bottom Right 3-Bank, Bottom Target || 40 Horseshoe Rollover || 48 Not Used
|}

=== Quelle ===

Schalterbelegung: Pinitech Switch Matrix Database, https://www.pinitech.com/switch_database.php

Kabelfarben: bei Williams System 3-7 einheitlich; belegt durch die Original-Handbuchblaetter von ''Contact'' (System 3, 1978, alle acht Spalten und Zeilen) und ''Laser Ball'' (System 6, 1979, Spalten 2-8), die identisch sind.
