bontango/WillFA7/docs/switch_matrix/22_Barracora.md

== Barracora ==

Williams ''Barracora'' (1981), System 7. 48 belegte Schalter, Matrix 6 x 8.

=== Switch Matrix ===

{| class="wikitable"
!  !! Column 1<br />GRN-BRN !! Column 2<br />GRN-RED !! Column 3<br />GRN-ORN !! Column 4<br />GRN-YEL !! Column 5<br />GRN-BLK !! Column 6<br />GRN-BLU
|-
! Return 1<br />WHT-BRN
| 01 Plumb Bob Tilt || 09 "Barracora" Lane Rollover || 17 1/4 Lane Rollover || 25 Spinner Target || 33 Upper Right Bull's-Eye Target || 41 B Drop Target
|-
! Return 2<br />WHT-RED
| 02 Ball Roll Tilt || 10 Upper Eject Hole || 18 2/5 Lane Rollover || 26 Right Turnaround || 34 Left Flipper Lane Change Switch || 42 A Drop Target
|-
! Return 3<br />WHT-ORN
| 03 Credit Button || 11 Lower Eject Hole || 19 3/6 Lane Rollover || 27 Left Bull's-Eye Target || 35 Right Flipper Lane Change Switch || 43 Rr Drop Target
|-
! Return 4<br />WHT-YEL
| 04 Right Coin Switch || 12 Outhole || 20 Left Jet Bumper || 28 Right Bull's-Eye Target || 36 Playfield Tilt || 44 A Drop Target
|-
! Return 5<br />WHT-GRN
| 05 Center Coin Switch || 13 Left Ball Ramp Switch || 21 Right Jet Bumpe || 29 Left Kicker || 37 Upper Right Standup || 45 C Drop Target
|-
! Return 6<br />WHT-BLU
| 06 Left Coin Switch || 14 Center Ball Ramp Switch || 22 Bottom Jet Bumper || 30 Right Kicker || 38 Lower Standup || 46 O Drop Target
|-
! Return 7<br />WHT-VIO
| 07 Slam Tilt || 15 Right Ball Ramp Switch || 23 Left Outside Rollover || 31 Left Inside Rollover || 39 5-Bank Standup || 47 R Drop Target
|-
! Return 8<br />WHT-GRY
| 08 High Score Reset || 16 Ball Shooter Trough Rollover || 24 Right Outside Rollover || 32 Right Inside Rollover || 40 Lower Left Standup || 48 A Drop Target
|}

=== Quelle ===

Schalterbelegung: Pinitech Switch Matrix Database, https://www.pinitech.com/switch_database.php

Kabelfarben: bei Williams System 3-7 einheitlich; belegt durch die Original-Handbuchblaetter von ''Contact'' (System 3, 1978, alle acht Spalten und Zeilen) und ''Laser Ball'' (System 6, 1979, Spalten 2-8), die identisch sind.
