bontango/WillFA7/docs/switch_matrix/23_Cosmic_Gunfight.md

== Cosmic Gunfight ==

Williams ''Cosmic Gunfight'' (1981), System 7. 51 belegte Schalter, Matrix 7 x 8.

=== Switch Matrix ===

{| class="wikitable"
!  !! Column 1<br />GRN-BRN !! Column 2<br />GRN-RED !! Column 3<br />GRN-ORN !! Column 4<br />GRN-YEL !! Column 5<br />GRN-BLK !! Column 6<br />GRN-BLU !! Column 7<br />GRN-VIO
|-
! Return 1<br />WHT-BRN
| 01 Plumb Bob Tilt || 09 X Rollover || 17 Not Used || 25 Top Eject Hole || 33 A-B-C Left Standup Target || 41 Left 3-Bank Center Drop Target || 49 Right Flipper Lane Change Switch
|-
! Return 2<br />WHT-RED
| 02 Ball Roll Tilt || 10 Y Rollover || 18 Right 3-Bank Standup || 26 Lower Eject Hole || 34 A-B-C Center Standup Target || 42 Left 3-Bank Top Drop Target || 50 Top Center Standup
|-
! Return 3<br />WHT-ORN
| 03 Credit Button || 11 Lane 1 Rollover || 19 Lower Right Standup || 27 Right Ball Ramp Switch || 35 A-B-C Right Standup Target || 43 Center 3-Bank Left Drop Target || 51 Ball Shooter Rollover
|-
! Return 4<br />WHT-YEL
| 04 Right Coin Chute || 12 Lane 2 Rollover || 20 Lower Left Standup || 28 Left Ball Ramp Switch || 36 Left Kicker || 44 Center 3-Bank Center Drop Target || 52 Left Flipper Lane Change Switch
|-
! Return 5<br />WHT-GRN
| 05 Center Coin Chute || 13 Lane 3 Rollover || 21 Left Jet Bumper || 29 Outhole || 37 Right Kicker || 45 Center 3-Bank Right Drop Target || 53 Not Used
|-
! Return 6<br />WHT-BLU
| 06 Left Coin Chute || 14 Top Right Side Lane Rollover || 22 Center Jet Bumper || 30 Playfield Tilt || 38 Left Flipper Lane Rollover || 46 Right 3-Bank Bottom Drop Target || 54 Not Used
|-
! Return 7<br />WHT-VIO
| 07 Slam Tilt || 15 Top Left Standup || 23 Right Jet Bumper || 31 Outer Left Drain Lane Rollover || 39 Right Flipper Lane Rollover || 47 Right 3-Bank Center Drop Target || 55 Not Used
|-
! Return 8<br />WHT-GRY
| 08 High Score Reset || 16 Top Right Standup || 24 Bottom Jet Bumper || 32 Outer Right Drain Lane Rollover || 40 Left 3-Bank Bottom Drop Target || 48 Right 3-Bank Top Drop Target || 56 Not Used
|}

=== Quelle ===

Schalterbelegung: Pinitech Switch Matrix Database, https://www.pinitech.com/switch_database.php

Kabelfarben: bei Williams System 3-7 einheitlich; belegt durch die Original-Handbuchblaetter von ''Contact'' (System 3, 1978, alle acht Spalten und Zeilen) und ''Laser Ball'' (System 6, 1979, Spalten 2-8), die identisch sind.
