bontango/WillFA7/docs/switch_matrix/24_Varkon.md

== Varkon ==

Williams ''Varkon'' (1982), System 7. 38 belegte Schalter, Matrix 6 x 8.

=== Switch Matrix ===

{| class="wikitable"
!  !! Column 1<br />GRN-BRN !! Column 2<br />GRN-RED !! Column 3<br />GRN-ORN !! Column 4<br />GRN-YEL !! Column 5<br />GRN-BLK !! Column 6<br />GRN-BLU
|-
! Return 1<br />WHT-BRN
| 01 Plumb Bob Tilt || 09 2-Player Start || 17 8 Standup Target, Llp || 25 Bull's-Eye Target, Llp || 33 Jet Bumper, Ulp || 41 Right Side Kicker, Ulp
|-
! Return 2<br />WHT-RED
| 02 Not Used || 10 Outhole/eject, Llp || 18 9 Standup Target, Llp || 26 Lane A Rollover, Ulp || 34 Ramp Chamber, Ulp || 42 Not Used
|-
! Return 3<br />WHT-ORN
| 03 1-Player Start || 11 Not Used || 19 10 Standup Target, Llp || 27 Lane V Rollover, Ulp || 35 Outhole/eject, Ulp || 43 Not Used
|-
! Return 4<br />WHT-YEL
| 04 Right Coin Chute || 12 Not Used || 20 5 Standup Target, Ulp || 28 Flipper Return Lane R Rollover, Ulp || 36 Top Left Standup Switch, Ulp || 44 Not Used
|-
! Return 5<br />WHT-GRN
| 05 Center Coin Chute || 13 B Standup Target, Llp || 21 4 Standup Target, Ulp || 29 K Standup Target, Ulp || 37 Bottom Left Standup Switch, Ulp || 45 Not Used
|-
! Return 6<br />WHT-BLU
| 06 Left Coin Chute || 14 A Standup Target, Llp || 22 3 Standup Target, Ulp || 30 O Standup Target, Ulp || 38 Center Left Standup Switch, Ulp || 46 Not Used
|-
! Return 7<br />WHT-VIO
| 07 Slam Tilt || 15 6 Standup Target, Llp || 23 2 Standup Target, Ulp || 31 N Standup Target, Ulp || 39 Lane Change Right || 47 Not Used
|-
! Return 8<br />WHT-GRY
| 08 High Score Reset || 16 7 Standup Target, Llp || 24 1 Standup Target, Ulp || 32 Spinner, Ulp || 40 Lane Change Left || 48 Not Used
|}

=== Quelle ===

Schalterbelegung: Pinitech Switch Matrix Database, https://www.pinitech.com/switch_database.php

Kabelfarben: bei Williams System 3-7 einheitlich; belegt durch die Original-Handbuchblaetter von ''Contact'' (System 3, 1978, alle acht Spalten und Zeilen) und ''Laser Ball'' (System 6, 1979, Spalten 2-8), die identisch sind.
