bontango/WillFA7/docs/switch_matrix/25_Warlok.md

== Warlok ==

Williams ''Warlok'' (1982), System 7. 39 belegte Schalter, Matrix 5 x 8.

=== Switch Matrix ===

{| class="wikitable"
!  !! Column 1<br />GRN-BRN !! Column 2<br />GRN-RED !! Column 3<br />GRN-ORN !! Column 4<br />GRN-YEL !! Column 5<br />GRN-BLK
|-
! Return 1<br />WHT-BRN
| 01 Plumb Bob Tilt || 09 Outhole || 17 "Y" || 25 Right Flipper Return Lane || 33 Upper Drop Target Bank - Left
|-
! Return 2<br />WHT-RED
| 02 Ball Roll Tilt || 10 Left Spinner || 18 "Z" || 26 Right Outlane || 34 Upper Drop Target Bank - Center
|-
! Return 3<br />WHT-ORN
| 03 Credit Button || 11 Upper Right Spinner || 19 Top Left Target || 27 Left Drop Target Bank - Left || 35 Upper Drop Target Bank - Right
|-
! Return 4<br />WHT-YEL
| 04 Right Coin Switch || 12 Lower Right Spinner || 20 Left Kicker || 28 Left Drop Target Bank - Center || 36 Lane Change
|-
! Return 5<br />WHT-GRN
| 05 Center Coin Switch || 13 Left Jet Bumper || 21 Right Kicker || 29 Left Drop Target Bank - Right || 37 Left Upper Rollunder
|-
! Return 6<br />WHT-BLU
| 06 Left Coin Switch || 14 Right Jet Bumper || 22 Right Ball Exit || 30 Center Drop Target Bank - Left || 38 Right Upper Rollunder
|-
! Return 7<br />WHT-VIO
| 07 Slam Tilt || 15 Center Jet Bumper || 23 Left Outlane || 31 Center Drop Target Bank - Center || 39 Playfield Tilt
|-
! Return 8<br />WHT-GRY
| 08 High Score Reset || 16 "X" || 24 Left Flipper Return Lane || 32 Center Drop Target Bank - Right || 40 Not Used
|}

=== Quelle ===

Schalterbelegung: Pinitech Switch Matrix Database, https://www.pinitech.com/switch_database.php

Kabelfarben: bei Williams System 3-7 einheitlich; belegt durch die Original-Handbuchblaetter von ''Contact'' (System 3, 1978, alle acht Spalten und Zeilen) und ''Laser Ball'' (System 6, 1979, Spalten 2-8), die identisch sind.
