bontango/WillFA7/docs/switch_matrix/26_Time_Fantasy.md

== Time Fantasy ==

Williams ''Time Fantasy'' (1982), System 7. 42 belegte Schalter, Matrix 6 x 8.

=== Switch Matrix ===

{| class="wikitable"
!  !! Column 1<br />GRN-BRN !! Column 2<br />GRN-RED !! Column 3<br />GRN-ORN !! Column 4<br />GRN-YEL !! Column 5<br />GRN-BLK !! Column 6<br />GRN-BLU
|-
! Return 1<br />WHT-BRN
| 01 Plumb Bob Tilt || 09 "F" || 17 Right Turnaround || 25 Lane 4 || 33 Top Left Jet Bumper || 41 Playfield Tilt
|-
! Return 2<br />WHT-RED
| 02 Ball Roll Tilt || 10 "A" || 18 Left Drain Lane || 26 Lane 5 || 34 Right Jet Bumper || 42 Left Lane Switch
|-
! Return 3<br />WHT-ORN
| 03 Credit Button || 11 "N" || 19 Right Drain Lane || 27 Lower Left Standup Target || 35 Bottom Left Jet Bumper || 43 Not Used
|-
! Return 4<br />WHT-YEL
| 04 Right Coin Switch || 12 "T" || 20 Left Flipper Return Lane || 28 Upper Left Standup Target || 36 Ramp Standup Target Timetube || 44 Not Used
|-
! Return 5<br />WHT-GRN
| 05 Center Coin Switch || 13 "A" || 21 Right Flipper Return Lane || 29 Upper Top Right Standup Target || 37 Left Kicker || 45 Not Used
|-
! Return 6<br />WHT-BLU
| 06 Left Coin Switch || 14 "S" || 22 Lane 1 || 30 Upper Center Right Standup Target || 38 Right Kicker || 46 Not Used
|-
! Return 7<br />WHT-VIO
| 07 Slam Tilt || 15 "Y" || 23 Lane 2 || 31 Upper Bottom Right Standup Target || 39 Outhole || 47 Not Used
|-
! Return 8<br />WHT-GRY
| 08 High Score Reset || 16 Left Turnaround || 24 Lane 3 || 32 Lower Right Standup Target || 40 Flipper Lane Change || 48 Not Used
|}

=== Quelle ===

Schalterbelegung: Pinitech Switch Matrix Database, https://www.pinitech.com/switch_database.php

Kabelfarben: bei Williams System 3-7 einheitlich; belegt durch die Original-Handbuchblaetter von ''Contact'' (System 3, 1978, alle acht Spalten und Zeilen) und ''Laser Ball'' (System 6, 1979, Spalten 2-8), die identisch sind.
