bontango/WillFA7/docs/switch_matrix/28_Firepower_II.md

== Firepower II ==

Williams ''Firepower II'' (1983), System 7. 48 belegte Schalter, Matrix 7 x 8.

=== Switch Matrix ===

{| class="wikitable"
!  !! Column 1<br />GRN-BRN !! Column 2<br />GRN-RED !! Column 3<br />GRN-ORN !! Column 4<br />GRN-YEL !! Column 5<br />GRN-BLK !! Column 6<br />GRN-BLU !! Column 7<br />GRN-VIO
|-
! Return 1<br />WHT-BRN
| 01 Plumb Bob Tilt || 09 Outhole || 17 Standup || 25 "F" Target || 33 "R" Target || 41 Lower Left Jet Bumper || 49 Playfield Tilt
|-
! Return 2<br />WHT-RED
| 02 Ball Roll Tilt || 10 Right Ball Ramp || 18 Spinner || 26 "I" Target || 34 "A" Rollover || 42 Upper Right Jet Bumper || 50 Not Used
|-
! Return 3<br />WHT-ORN
| 03 Credit Button || 11 Left Ball Ramp || 19 Orbit in Roll Under || 27 "R" Target || 35 "B" Rollover || 43 Upper Left Jet Bumper || 51 Not Used
|-
! Return 4<br />WHT-YEL
| 04 Right Coin || 12 Ball Shooter Trough || 20 Upper Left Standup || 28 "E" Target || 36 "C" Rollover || 44 Lower Right Jet Bumper || 52 Not Used
|-
! Return 5<br />WHT-GRN
| 05 Center Coin || 13 Lane Change || 21 Not Used || 29 "P" Target || 37 "D" Rollover || 45 Left Flipper Return Lane || 53 Not Used
|-
! Return 6<br />WHT-BLU
| 06 Left Coin || 14 Ramp in Roll Under || 22 Upper Right Standup || 30 "O" Target || 38 Left Outlane || 46 Right Flipper Return Lane || 54 Not Used
|-
! Return 7<br />WHT-VIO
| 07 Slam Tilt || 15 Ramp Out Roll Under || 23 Eject Hole || 31 "W" Target || 39 Right Outlane || 47 Left Kicker || 55 Not Used
|-
! Return 8<br />WHT-GRY
| 08 High Score Reset || 16 Center Left Standup || 24 Release Target || 32 "E" Target || 40 Orbit Out Gate || 48 Right Kicker || 56 Not Used
|}

=== Quelle ===

Schalterbelegung: Pinitech Switch Matrix Database, https://www.pinitech.com/switch_database.php

Kabelfarben: bei Williams System 3-7 einheitlich; belegt durch die Original-Handbuchblaetter von ''Contact'' (System 3, 1978, alle acht Spalten und Zeilen) und ''Laser Ball'' (System 6, 1979, Spalten 2-8), die identisch sind.
