bontango/WillFA7/docs/switch_matrix/29_Laser_Cue.md

== Laser Cue ==

Williams ''Laser Cue'' (1984), System 7. 41 belegte Schalter, Matrix 6 x 8.

=== Switch Matrix ===

{| class="wikitable"
!  !! Column 1<br />GRN-BRN !! Column 2<br />GRN-RED !! Column 3<br />GRN-ORN !! Column 4<br />GRN-YEL !! Column 5<br />GRN-BLK !! Column 6<br />GRN-BLU
|-
! Return 1<br />WHT-BRN
| 01 Plumb Bob Tilt || 09 Outhole || 17 Upper Left Jet || 25 C || 33 1 || 41 Left Kicker
|-
! Return 2<br />WHT-RED
| 02 Ball Roll Tilt || 10 Flipper Return || 18 Upper Right Jet || 26 U || 34 2 || 42 Lower Right 10Pt
|-
! Return 3<br />WHT-ORN
| 03 Credit Button || 11 Left Special || 19 Lower Jet || 27 E || 35 3 || 43 Lane Change
|-
! Return 4<br />WHT-YEL
| 04 Left Coin || 12 Right Special || 20 B || 28 P || 36 4 || 44 Not Used
|-
! Return 5<br />WHT-GRN
| 05 Center Coin || 13 Not Used || 21 A || 29 O || 37 5 || 45 Not Used
|-
! Return 6<br />WHT-BLU
| 06 Right Coin || 14 Not Used || 22 L || 30 O || 38 6 || 46 Not Used
|-
! Return 7<br />WHT-VIO
| 07 Slam Tilt || 15 Right 50-Pt || 23 L || 31 L || 39 7 || 47 Not Used
|-
! Return 8<br />WHT-GRY
| 08 High Score Reset || 16 Upper Right 50-Pt || 24 Spinner || 32 Playfield Tilt || 40 8 || 48 Not Used
|}

=== Quelle ===

Schalterbelegung: Pinitech Switch Matrix Database, https://www.pinitech.com/switch_database.php

Kabelfarben: bei Williams System 3-7 einheitlich; belegt durch die Original-Handbuchblaetter von ''Contact'' (System 3, 1978, alle acht Spalten und Zeilen) und ''Laser Ball'' (System 6, 1979, Spalten 2-8), die identisch sind.
