bontango/WillFA7/docs/switch_matrix/31_Star_Light.md

== Star Light ==

Williams ''Star Light'' (1984), System 7. 54 belegte Schalter, Matrix 7 x 8.

=== Switch Matrix ===

{| class="wikitable"
!  !! Column 1<br />GRN-BRN !! Column 2<br />GRN-RED !! Column 3<br />GRN-ORN !! Column 4<br />GRN-YEL !! Column 5<br />GRN-BLK !! Column 6<br />GRN-BLU !! Column 7<br />GRN-VIO
|-
! Return 1<br />WHT-BRN
| 01 Plumb Bob Tilt || 09 Outhole || 17 L || 25 Spinner || 33 Star 8 || 41 Left Jet || 49 Upper Left Switch
|-
! Return 2<br />WHT-RED
| 02 Ball Roll Tilt || 10 Ramp 1 || 18 I || 26 Star 1 || 34 Star 9 || 42 Lower Jet || 50 Left Kicker
|-
! Return 3<br />WHT-ORN
| 03 Credit Button || 11 Ramp 2 || 19 G || 27 Star 2 || 35 Star 10 || 43 Right Jet || 51 Right Kicker
|-
! Return 4<br />WHT-YEL
| 04 Left Coin || 12 Shooter Lane Switch || 20 H || 28 Star 3 || 36 Top Lanes 1-2 || 44 Left Flipper Return || 52 Eject
|-
! Return 5<br />WHT-GRN
| 05 Center Coin || 13 S || 21 T || 29 Star 4 || 37 Top Lanes 3-4 || 45 Right Flipper Return || 53 Playfield Tilt
|-
! Return 6<br />WHT-BLU
| 06 Right Coin || 14 T || 22 Adv 'X' Top Left Target || 30 Star 5 || 38 Top Lanes 5-6 || 46 Left Special || 54 Lane Change
|-
! Return 7<br />WHT-VIO
| 07 Slam Tilt || 15 A || 23 Adv 'X' Right Lane || 31 Star 6 || 39 Top Lanes 7-8 || 47 Right Special || 55 Not Used
|-
! Return 8<br />WHT-GRY
| 08 High Score Reset || 16 R || 24 Adv 'X' Right Target || 32 Star 7 || 40 Top Lanes 9-10 || 48 Lower Left Switch || 56 Not Used
|}

=== Quelle ===

Schalterbelegung: Pinitech Switch Matrix Database, https://www.pinitech.com/switch_database.php

Kabelfarben: bei Williams System 3-7 einheitlich; belegt durch die Original-Handbuchblaetter von ''Contact'' (System 3, 1978, alle acht Spalten und Zeilen) und ''Laser Ball'' (System 6, 1979, Spalten 2-8), die identisch sind.
