bontango/WillFA7/docs/switch_matrix/README.md

# Switch-Matrizen der 32 von WillFA7 unterstuetzten Williams-Geraete

Je Spiel eine Datei im MediaWiki-Tabellenformat (Vorbild:
`../Switch_Matrix_Mata_Hari.md`), fertig zum Einfuegen in pinwiki.com.

Zuordnung: Schalter *N* liegt auf **Column (N-1) div 8 + 1**, **Return (N-1) mod 8 + 1**.
Verifiziert an der ROM-eigenen Switch-Nummer-Berechnung (`Switch-Nr = 8 x Strobe-Bit + Return-Bit + 1`)
und am Original-Handbuchblatt von Laser Ball.

| # | Spiel | Jahr | System | belegt | Datei | Quelle |
|---|---|---|---|---|---|---|
| 0 | Hot Tip | 1977 | System 3 | 35 | [00_Hot_Tip.md](00_Hot_Tip.md) | Handbuch |
| 1 | Lucky Seven | 1978 | System 3 | 38 | [01_Lucky_Seven.md](01_Lucky_Seven.md) | Handbuch |
| 2 | World Cup | 1978 | System 3 | 37 | [02_World_Cup.md](02_World_Cup.md) | Handbuch |
| 3 | Contact | 1978 | System 3 | 39 | [03_Contact.md](03_Contact.md) | Handbuch |
| 4 | Disco Fever | 1978 | System 3 | 35 | [04_Disco_Fever.md](04_Disco_Fever.md) | Handbuch |
| 5 | Pokerino | 1978 | System 4 | 46 | [05_Pokerino.md](05_Pokerino.md) | Handbuch |
| 6 | Phoenix | 1978 | System 4 | 46 | [06_Phoenix.md](06_Phoenix.md) | Handbuch |
| 7 | Flash | 1979 | System 4 | 48 | [07_Flash.md](07_Flash.md) | Handbuch |
| 8 | Stellar Wars | 1979 | System 4 | 52 | [08_Stellar_Wars.md](08_Stellar_Wars.md) | Handbuch |
| 9 | Tri Zone | 1979 | System 6 | 35 | [09_Tri_Zone.md](09_Tri_Zone.md) | Pinitech |
| 10 | Time Warp | 1979 | System 6 | 44 | [10_Time_Warp.md](10_Time_Warp.md) | Pinitech |
| 11 | Gorgar | 1979 | System 6 | 44 | [11_Gorgar.md](11_Gorgar.md) | Pinitech |
| 12 | Laser Ball | 1979 | System 6 | 58 | [12_Laser_Ball.md](12_Laser_Ball.md) | Handbuch |
| 13 | Firepower | 1980 | System 6 | 53 | [13_Firepower.md](13_Firepower.md) | Pinitech |
| 14 | Blackout | 1980 | System 6 | 43 | [14_Blackout.md](14_Blackout.md) | Pinitech |
| 15 | Scorpion | 1980 | System 6 | 57 | [15_Scorpion.md](15_Scorpion.md) | Handbuch |
| 16 | Algar | 1980 | System 6A | 53 | [16_Algar.md](16_Algar.md) | Pinitech |
| 17 | Alien Poker | 1980 | System 6A | 43 | [17_Alien_Poker.md](17_Alien_Poker.md) | Pinitech |
| 18 | Black Knight | 1980 | System 7 | 43 | [18_Black_Knight.md](18_Black_Knight.md) | Pinitech |
| 19 | Jungle Lord | 1981 | System 7 | 48 | [19_Jungle_Lord.md](19_Jungle_Lord.md) | Pinitech |
| 20 | Pharaoh | 1981 | System 7 | 41 | [20_Pharaoh.md](20_Pharaoh.md) | Pinitech |
| 21 | Solar Fire | 1981 | System 7 | 43 | [21_Solar_Fire.md](21_Solar_Fire.md) | Pinitech |
| 22 | Barracora | 1981 | System 7 | 48 | [22_Barracora.md](22_Barracora.md) | Pinitech |
| 23 | Cosmic Gunfight | 1981 | System 7 | 51 | [23_Cosmic_Gunfight.md](23_Cosmic_Gunfight.md) | Pinitech |
| 24 | Varkon | 1982 | System 7 | 38 | [24_Varkon.md](24_Varkon.md) | Pinitech |
| 25 | Warlok | 1982 | System 7 | 39 | [25_Warlok.md](25_Warlok.md) | Pinitech |
| 26 | Time Fantasy | 1982 | System 7 | 42 | [26_Time_Fantasy.md](26_Time_Fantasy.md) | Pinitech |
| 27 | Joust | 1983 | System 7 | 58 | [27_Joust.md](27_Joust.md) | Pinitech |
| 28 | Firepower II | 1983 | System 7 | 48 | [28_Firepower_II.md](28_Firepower_II.md) | Pinitech |
| 29 | Laser Cue | 1984 | System 7 | 41 | [29_Laser_Cue.md](29_Laser_Cue.md) | Pinitech |
| 30 | Defender | 1982 | System 7 | 58 | [30_Defender.md](30_Defender.md) | Pinitech |
| 31 | Star Light | 1984 | System 7 | 54 | [31_Star_Light.md](31_Star_Light.md) | Pinitech |

## Hinweis zur Quelle

Elf Matrizen (Hot Tip, Lucky Seven, World Cup, Contact, Disco Fever, Pokerino,
Phoenix, Flash, Stellar Wars, Laser Ball, Scorpion) stammen aus den
Original-Handbuchblaettern, die uebrigen 21 aus der Pinitech Switch Matrix Database
(https://www.pinitech.com/switch_database.php). Die Schalterbelegung selbst ist in
beiden Faellen Herstellerangabe aus den Williams-Handbuechern. Beim Einpflegen in
pinwiki.com sollte die jeweilige Quelle mit angegeben werden.

Wo Handbuchblatt und Datenbank auseinanderlaufen, gilt das Handbuchblatt. Bisher
betrifft das drei Geraete:

| Spiel | Datenbank | Handbuchblatt |
|---|---|---|
| Contact | Column 1 komplett "not used" | Column 1 regulaer belegt (Tilts, Muenzen, Credit, Slam) |
| Phoenix | sw27 und sw43 "not used" | beides Drop Targets - die Banks haben je vier, nicht drei |
| Stellar Wars | sw34 und sw35 beide "Series" | sw34 Series, sw35 **Standup** der rechten 3-Bank |
