bontango/WillFA7/docs/Switch_Matrix_Mata_Hari.md

==Switch Matrix==

{| class="wikitable"
!  !!  !!  !! Strobe 0 !! Strobe 1 !! Strobe 2 !! Strobe 3 !! Strobe 4
|-
! 
| to Playfield || -- || A4J2-1 Wht-Red (51) || A4J2-2 Gry-Yel (93) || A4J2-3 Wht-Blu (52) || A4J2-4 Wht-Yel (53) || A4J2-5 Yel-Red (31)
|-
! 
| -- || to Cabinet || A4J3-2 Red-Yel (13) || A4J3-3 Red-Grn (14) ||  ||  || 
|-
! Return I-0
| A4J2-8 Wht-Grn (54) || A4J3-9 Red-Wht (15) || 1 Not Used || 9 Coin Chute III (Right) || 17 Right Drop Target D (Bottom) || 25 Right Flipper Feeder Lane || 33 Right Outlane
|-
! Return I-1
| A4J2-9 Wht-Brn (56) || A4J3-10 Brn-Wht (65) || 2 Not Used || 10 Coin Chute I (Left) || 18 Right Drop Target C || 26 Left Flipper Feeder Lane || 34 Left Outlane
|-
! Return I-2
| A4J2-10 Wht-Orn (57) || A4J3-11 Blu (20) || 3 Not Used || 11 Coin Chute II (Middle) || 19 Right Drop Target B || 27 10 Point Drop Target Rebound (2) || 35 Right Slingshot
|-
! Return I-3
| A4J2-11 Wht-Blk (58) || A4J3-12 Blu-Red (21) || 4 Not Used || 12 Not Used || 20 Right Drop Target A (Top) || 28 Right 'B' Lane || 36 Left Slingshot
|-
! Return I-4
| A4J2-12 Brn (60) || A4J3-13 Blu-Yel (23) || 5 Not Used || 13 Not Used || 21 Left Drop Target D (Bottom) || 29 Left 'A' Lane || 37 Bottom Right Thumper Bumper
|-
! Return I-5
| A4J2-13 Brn-Yel (63) || A4J3-14 Blu-Wht (25) || 6 Credit Button || 14 Not Used || 22 Left Drop Target C || 30 Top 'B' Lane || 38 Bottom Left  Thumper Bumper
|-
! Return I-6
| A4J2-14 Brn-Wht (65) || A4J3-15 Blu-Orn (27) || 7 Tilt (3) || 15 Not Used || 23 Left Drop Target B || 31 Top 'A' Lane || 39 Top Right Thumper Bumper
|-
! Return I-7
| A4J2-15 Orn (70) || A4J3-16 Yel (30) || 8 Outhole || 16 Slam (2) || 24 Left Drop Target A (Top) || 32 Top Saucer || 40 Top Left Thumper Bumper
|}
