bontango/WillFA7/docs/switch_matrix/27_Joust.md

== Joust ==

Williams ''Joust'' (1983), System 7. 58 belegte Schalter, Matrix 8 x 8.

=== Switch Matrix ===

{| class="wikitable"
!  !! Column 1<br />GRN-BRN !! Column 2<br />GRN-RED !! Column 3<br />GRN-ORN !! Column 4<br />GRN-YEL !! Column 5<br />GRN-BLK !! Column 6<br />GRN-BLU !! Column 7<br />GRN-VIO !! Column 8<br />GRN-GRY
|-
! Return 1<br />WHT-BRN
| 01 Plumb Bob Tilt || 09 Outhole || 17 Disappearing Target (Front) || 25 Left 3-Bank, Drop Target (Right) || 33 Outhole || 41 Disappearing Target (Front) || 49 Left 3 Bank, Drop Target (Right) || 57 2-Player Start
|-
! Return 2<br />WHT-RED
| 02 Not Used || 10 Ball Ramp 1 (Right) || 18 Disappearing Target (Rear) || 26 Right 3 Bank, Drop Target (Left) || 34 Ball Ramp 1 (Right) || 42 Disappearing Target (Rear) || 50 Right 3 Bank, Drop Target (Left) || 58 P1 Left Flap
|-
! Return 3<br />WHT-ORN
| 03 1-Player Start || 11 Ball Ramp 2 || 19 Disappearing Target Rollover || 27 Right 3 Bank, Drop Target (Center) || 35 Ball Ramp 2 || 43 Disappearing Target Rollover || 51 Right 3 Bank, Drop Target (Center) || 59 P1 Right Flap
|-
! Return 4<br />WHT-YEL
| 04 Right Coin Chute || 12 Ball Ramp 3 || 20 Hunter Rollover 1 || 28 Right 3 Bank, Drop Target (Right) || 36 Ball Ramp 3 || 44 Hunter Rollover 1 || 52 Right 3 Bank, Drop Target (Right) || 60 P2 Left Flap
|-
! Return 5<br />WHT-GRN
| 05 Center Coin Chute || 13 Ball Ramp 4 (Left) || 21 Hunter Bullseye 2 || 29 Left Kicker || 37 Ball Ramp 4 (Left) || 45 Hunter Bullseye 2 || 53 Left Kicker || 61 P2 Right Flap
|-
! Return 6<br />WHT-BLU
| 06 Left Coin Chute || 14 Shooter Lane || 22 Hunter Bullseye 3 || 30 Right Kicker || 38 Shooter Lane || 46 Hunter Bullseye 3 || 54 Right Kicker || 62 Not Used
|-
! Return 7<br />WHT-VIO
| 07 Slam Tilt || 15 Eject Hole || 23 Left 3 Bank, Drop Target (Left) || 31 Right Drain Rollover || 39 Eject Hole || 47 Left 3 Bank, Drop Target (Left) || 55 Right Drain Rollover || 63 Not Used
|-
! Return 8<br />WHT-GRY
| 08 High Score Reset || 16 Spinner || 24 Left 3 Bank, Drop Target (Center) || 32 Not Used || 40 Spinner || 48 Left 3 Bank, Drop Target (Center) || 56 Not Used || 64 Not Used
|}

=== Quelle ===

Schalterbelegung: Pinitech Switch Matrix Database, https://www.pinitech.com/switch_database.php

Kabelfarben: bei Williams System 3-7 einheitlich; belegt durch die Original-Handbuchblaetter von ''Contact'' (System 3, 1978, alle acht Spalten und Zeilen) und ''Laser Ball'' (System 6, 1979, Spalten 2-8), die identisch sind.
