bontango/WillFA7/docs/switch_matrix/30_Defender.md

== Defender ==

Williams ''Defender'' (1982), System 7. 58 belegte Schalter, Matrix 8 x 8.

=== Switch Matrix ===

{| class="wikitable"
!  !! Column 1<br />GRN-BRN !! Column 2<br />GRN-RED !! Column 3<br />GRN-ORN !! Column 4<br />GRN-YEL !! Column 5<br />GRN-BLK !! Column 6<br />GRN-BLU !! Column 7<br />GRN-VIO !! Column 8<br />GRN-GRY
|-
! Return 1<br />WHT-BRN
| 01 Plumb Bob Tilt || 09 Bomber Lane 1 Rollover || 17 Left Lander Drop Target 5 (Top) || 25 Right Lander Drop Target 3 || 33 Disappearing Baiter Target (Bottom) || 41 Pod Bull's Eye Target || 49 Ball Ramp (Left) || 57 Left Kicker
|-
! Return 2<br />WHT-RED
| 02 Ball Roll Tilt || 10 Bomber Lane 2 Rollover || 18 Not Used || 26 Right Lander Drop Target 4 || 34 Disappearing Baiter Target (Center) || 42 Lockup Trough (Bottom) || 50 Ball Shooter Trough || 58 Right Kicker
|-
! Return 3<br />WHT-ORN
| 03 Credit Button || 11 Bomber Lane 3 Rollover || 19 Left Mutant Bull's Eye Target 2 || 27 Right Lander Drop Target 5 (Top) || 35 Disappearing Baiter Target (Top) || 43 Lockup Trough (Center) || 51 Left Outlane || 59 Flipper Lane Change Switch
|-
! Return 4<br />WHT-YEL
| 04 Right Coin || 12 Bomber Lane 4 Rollover || 20 Left Mutant Bull's Eye Target 3 || 28 Not Used || 36 Swarmer Bull's Eye Target (Top) || 44 Lockup Trough (Top) || 52 Right Outlane || 60 Smart Bomb
|-
! Return 5<br />WHT-GRN
| 05 Center Coin || 13 Left Lander Drop Target 1 (Bottom) || 21 Left Mutant Bull's Eye Target 4 || 29 Right Mutant Bull's Eye Target 2 || 37 Swarmer Bull's Eye Target (Bottom) || 45 Lockup Trough Rollover || 53 Left Flipper Return Lane || 61 Reverse
|-
! Return 6<br />WHT-BLU
| 06 Left Coin || 14 Left Lander Drop Target 2 || 22 Not Used || 30 Right Mutant Bull's Eye Target 3 || 38 Swarmer Standup || 46 Outhole || 54 Right Flipper Return Lane || 62 Not Used
|-
! Return 7<br />WHT-VIO
| 07 Slam Tilt || 15 Left Lander Drop Target 3 || 23 Right Lander Drop Target 1 (Bottom) || 31 Right Mutant Bull's Eye Target 4 || 39 Dissapearing Pod Target (Bottom) || 47 Ball Ramp (Right) || 55 Left Jet Bumper || 63 Playfield Tilt
|-
! Return 8<br />WHT-GRY
| 08 High Score Reset || 16 Left Lander Drop Target 4 || 24 Right Lander Drop Target 2 || 32 Not Used || 40 Dissapearing Pod Target (Top) || 48 Ball Ramp (Center) || 56 Right Jet Bumper || 64 Not Used
|}

=== Quelle ===

Schalterbelegung: Pinitech Switch Matrix Database, https://www.pinitech.com/switch_database.php

Kabelfarben: bei Williams System 3-7 einheitlich; belegt durch die Original-Handbuchblaetter von ''Contact'' (System 3, 1978, alle acht Spalten und Zeilen) und ''Laser Ball'' (System 6, 1979, Spalten 2-8), die identisch sind.
