bontango/WillFA7/rtl/common/version_pkg.vhd

-- version_pkg - the common function level of all WillFA7 board variants
-- Ralf Thelen 'bontango' - www.lisy.dev
--
-- The displayed version is BOARD_ID.SW_SUB1 SW_SUB2, for example 3.22:
--   BOARD_ID  first digit  - identifies the board, see variants/<name>/variant_pkg.vhd
--   SW_SUB1   second digit - common function level, set here
--   SW_SUB2   third digit  - common function level, set here
--
-- A release changes exactly one number in this file and every variant follows.
--
-- Function level history (see bin/changelog.txt for the full text):
--   .17  EEprom write robustness            .18  switch matrix debouncer
--   .19  special solenoid debounce via DIP4  .20  per game switch debounce masks
--   .21  monorepo: one shared top level, generated .qsf, no functional change
--   .22  the sound board variant joins the shared top level (HAS_SOUND), one
--        SD_Card for all, and Cyclone II gets the WillFA7_cii board shell because
--        VIRTUAL_PIN does not work on Quartus 13.0sp1 Web Edition - four pins of
--        the EP2C5 that 1.21 drove are free again. Plus the boot message on six AND
--        seven digit player displays (docs/display_layout.md) and the is_sys3 fix
-- x.30   back to the x.20 SD card (12 KByte slots, no CRC) for every board, Cyclone II
--        included; the sound board ROMs in a second area of the card. Game ROMs from
--        the configuration flash when no card answers (HAS_FLASH_ROM, WillFA7S so far)
--
library ieee;
use ieee.std_logic_1164.all;

package version_pkg is
	constant SW_SUB1 : std_logic_vector(3 downto 0) := x"3";
	constant SW_SUB2 : std_logic_vector(3 downto 0) := x"0";
end package;
