bontango/WillFA7/rtl/sound/slow_to_fast_clock_bus.vhd

-- from https://www.nandland.com/articles/crossing-clock-domains-in-an-fpga.html
-- adapted by bontango
-- 8 bit version of rtl/common/slow_to_fast_clock.vhd
--
-- Taken from the WISOF project (version 0.9). It lives here and not in rtl/common
-- because the sound board is its only user: WISOF hands the DAC value over from the
-- sound PIA (cpu_clk) to the audio mixer (clk_50).

Library IEEE;
USE IEEE.Std_logic_1164.all;

entity Cross_Slow_To_Fast_Clock_Bus is
   port(
      i_D :in  std_logic_vector(7 downto 0);
	  o_Q : out std_logic_vector(7 downto 0);
	  i_Fast_Clk :in std_logic
   );
end Cross_Slow_To_Fast_Clock_Bus;
architecture Behavioral of Cross_Slow_To_Fast_Clock_Bus is

	signal r1_Data : std_logic_vector(7 downto 0) := (others => '0');
	signal r2_Data : std_logic_vector(7 downto 0) := (others => '0');

begin
 -- crossing data from slow to fast domain
 process(i_Fast_Clk)
 begin
    if(rising_edge(i_Fast_Clk)) then
     -- r1_data is METASTABLE, r2_Data is stable
	 r1_Data <= i_D;
	 r2_Data <= r1_Data;

	 -- Can use r2_Data now
	 o_Q <= r2_Data;

  end if;
 end process;
end Behavioral;
