bontango/WillFA7/(commit log)

2023-02-23 cpu68 core bugfixes
    fixed 'add'; 'tst' and interrupt handling bugs. Own version number set to 0.83 ( as it is based on 0.8 )
    [cpu68.vhd]
2026-05-04 EEprom: read-before-write save scan, no shadow cache
    Replaces the 256-byte shadow cache with a per-byte EEPROM READ in the
    save-scan path: PH_SCAN_SETTLE -> PH_SCAN_READ -> PH_SCAN_DECIDE compares
    the freshly-read EEPROM byte against q_ram and only writes on mismatch.
    EEPROM is the single source of truth -- no shadow drift, no init-sync
    edge cases. Frees ~256 LCs (or 1 M9K block vs the BRAM variant).
    LED feedback gated by new write_seen latch: stays dark for read-only
    saves (no actual writes), blinks at 1 Hz only after the first
    PH_WRITE_WREN of a save cycle, cleared on transition back to PH_IDLE.
    Removes lib_cyclone_IV/shadow_ram.{vhd,qip,cmp} and the QIP_FILE entry
    in WillFA7.qsf. CLAUDE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
    [EEprom.vhd]
2026-07-25 v3.18: Switch-Matrix Hardware-Entpreller (sw_debounce.vhd)
    Per-Switch, strobe-aware Entprellung der Switch-Matrix-Returns mit
    game-aware DEBOUNCE_MASK: Level-/Spinner-/Jet-Switches bleiben roh,
    der Rest wird entprellt. Umschaltbar ueber DIP5
    (game_option(5)='0' = ON = Entprellung, OFF = v3.17-Passthrough).
    Globale Filter (N-of-N, Lockout, Integrator) haben nicht funktioniert,
    weil der ROM-Dispatch bei $60F1 pro Switch unterschiedlich reagiert --
    Analyse in docs/switch_debounce_analysis.md.
    Hardware-Test Alien Poker mit DIP5 ON: Targetbank stellt nur einmal auf,
    Outhole wirft einmal aus, Eject Holes sauberer Single-Eject,
    Standup-Targets ohne Doppelzaehlung, Spinner ~70 statt ~50 Umdrehunge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
2026-07-25 v3.19: Spezialsolenoid-Debounce ueber DIP4 umschaltbar (57us -> 250us)
    Beim Alien-Poker-Test loeste der Kontakt des bottom Jet Bumper (Sol 20) in
    ca. 50 % der Faelle zeitgleich auch Sol 19 (right Jet Bumper) aus.
    Ursache: Die Eingangsstufe ist 4,7K Pull-up + C nach GND + 74HC4049 ohne
    Schmitt-Trigger (R1..R6 / C3..C8 / IC1). Ein von der Sol-20-Ansteuerung
    eingekoppelter Impuls entlaedt den Kondensator; die Leitung braucht danach
    1..2 tau (~50..100us bei 10nF) zum Zurueckladen und meldet solange
    "Kontakt geschlossen". Die feste Debounce-Schwelle von counter > 50
    cpu_clk-Zyklen (~57us) lag exakt in diesem Fenster -- daher die ~50 %.
    Interner Uebersprecher und MPU-Pfad sind ausgeschlossen: di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
2026-07-26 v3.20: Switch-Debounce-Masken spielabhaengig (MASK_ROM)
    sw_debounce.vhd bekommt einen game-Eingang (0..31) und waehlt die
    per-Switch-Maske aus einer MASK_ROM statt der fest verdrahteten
    Alien-Poker-Tabelle. Damit hat jedes unterstuetzte Spiel seine eigene
    Tabelle; die Alien-Poker-Maske ist bitgleich zu v3.18/v3.19.
    Die Masken trennen Level-/Confirm-Read-Schalter (Drop-Target-Baenke,
    Outhole/Trough, Eject Holes, Kicker, Locks, Ramps), Spinner und Jets
    (bleiben RAW) von den momentanen Schaltern (Stand-ups, Rollover, Lanes,
    Cabinet), die entprellt werden. Quellen und Herleitung je Spiel in
    docs/switch_matrix/ und docs/switch_masks.md.
    Nebenbei: die Versionskonstante stand bis einschliesslich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
2026-07-26 v3.20 FIX: LED_active ist die Blanking-Leitung, nicht nur eine LED
    PIN_3 (LED_active) haengt auf der WillFA7-Platine am /OE von IC13
    (74HCT240, switch strobes) und ueber T9 invertiert als blanking_n an den
    /RESET-Eingaengen von IC3/4/5 (Solenoid-Latches) und IC6/7 (Lamp-Latches).
    '1' loescht also alle Spulen- und Lampen-Latches und legt die
    Switch-Matrix still.
    v3.17 (a25f2f1) hat den Pin fuer eine EEprom-Anzeige mitbenutzt:
    LED_active <= eeprom_error_sig when eeprom_wr_in_progress = '0' else blanking;
    eeprom_error_sig ist der freilaufende 1-Hz-Blinkgenerator aus EEprom.vhd
    (blink_q, sobald write_seen gesetzt ist). Damit hing die Blanking-Leitung
    am Blinker. Beobachtetes Fehlerbild ab v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
    [WillFA7.vhd]
2026-07-26 docs: gescannte Handbuchseiten aus dem Repository nehmen
    Die Switchmatrix- und Playfield-Scans sind Handbuchmaterial und gehoeren
    nicht in ein oeffentliches Repo. Sie bleiben lokal in docs/ liegen und sind
    ab jetzt per .gitignore ausgenommen; im Repo steht nur noch die daraus
    abgeleitete Textform in docs/switch_matrix/.
    Betrifft die sieben mit 91b905d hinzugekommenen Scans sowie die beiden
    laenger vorhandenen Alien-Poker-Bilder. Der Loeschcommit nimmt sie aus der
    Spitze - ueber die alten Commit-SHAs bleiben sie abrufbar, dafuer waere ein
    History-Rewrite noetig.
    Nebenbei roms/ und Thumbs.db in die .gitignore aufgenommen.
2026-07-26 v3.20: Switch-Matrizen Pokerino/Phoenix/Flash/Stellar Wars aus Handbuchblaettern
    Vier Original-Handbuchblaetter nachgetragen und gegen die bisherigen
    Pinitech-Daten sowie gegen die ROM-Dispatch-Tabellen geprueft.
    Eine funktionale Aenderung:
    - Stellar Wars, Spaltenbyte 5: 28 -> 2C. Die Datenbank fuehrt sw34 UND
    sw35 als "Series"; laut Handbuch ist sw34 die Series und sw35 der
    Standup der rechten 3-Bank. Beide 3-Banks sind damit symmetrisch
    (16/17/18 + 19 Series + 20 Standup links, 31/32/33 + 34 Series +
    35 Standup rechts). sw35 wird nach der STANDUP-Regel entprellt.
    Ohne Maskenaenderung, aber Datenkorrektur:
    - Phoenix sw27 und sw43 sind Drop Targets, in der Datenbank als
    "not used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
2026-07-27 Step 1: move all five active variants into the monorepo layout
    Sources are now shared instead of copied per variant:
    rtl/common the 20 modules every variant uses (was lib_common, four copies)
    rtl/cyclone_ii rtl/cyclone_iv rtl/cyclone_10 family megafunctions
    rtl/serial_api USB monitor API, only cyclone_iv_v3 pulls it in
    variants/<name> per board: WillFA7.vhd (still one each), .qsf, .sdc, .qpf, .cof
    scripts/ check.ps1 plus the file lists gen_qsf.ps1 will assemble
    Fixed on the way: the altsyncram init_file in all three R5101.vhd was relative to
    the project directory (./ROM/... resp. ./lib_common/...). The project directory
    is now variants/<name>/, so both paths point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
    [baseline.csv]
2026-07-27 Step 2: version constants move into packages
    SW_MAIN/SW_SUB1/SW_SUB2 were three constants in every WillFA7.vhd, which is how
    v3.19 shipped while the display still said 3.18. They are now:
    rtl/common/version_pkg.vhd SW_SUB1, SW_SUB2 - the common function level
    variants/<n>/variant_pkg.vhd BOARD_ID - which board this build is for
    The boot message reads BOARD_ID, SW_SUB1, SW_SUB2. A release changes one number in
    version_pkg.vhd and every variant follows; the two cannot drift apart any more.
    Both packages are the first VHDL_FILE entries in each .qsf so the analyser never
    has to work out the order.
    The real risk here was Quartus 13.0sp1: it is the only toolchain in the project
    tha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
    [WillFA7.vhd]
2026-07-27 Steps 3 and 4: R5101 port list and the display signals
    Two changes that make the five top levels converge without changing any hardware.
    R5101 on Cyclone II now has the same clock_a/clock_b port list as the other two
    families, so the top level instantiates it identically everywhere. The megafunction
    underneath is unchanged and still single clock - clock0 is tied to clock_b (clk_50),
    exactly as this board has run since v1.00. clock_a is deliberately not connected,
    with the reason written at the port: wiring it up would move CMOS port B from clk_50
    to mem_clk and change the EEprom scan path on a board nobody has tested since 07.2026.
    The display outputs get internal signals disp_bcd_i / disp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
2026-07-27 Step 5: one port list for all five variants
    The entity of WillFA7.vhd is now byte identical in every variant. LED_debug (dev
    board only), USB_Tx, USB_Rx and debug (serial monitor only) are declared everywhere;
    boards that do not have the pin get VIRTUAL_PIN in their .qsf, listed in
    variants/<name>/variant.psd1.
    VIRTUAL_PIN is not cosmetic here. A declared output port without a location is a
    *used* pin to Quartus - RESERVE_ALL_UNUSED_PINS does not cover it - so it would be
    placed and driven on whatever pin the fitter picks. On a real WillFA7 board that can
    pull an active net to ground.
    The pin number comments that used to sit in the port list are gone. They were the
    Cyclone II numbers copie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
    [baseline.csv]
2026-07-27 Steps 6 to 8: ONE top level for all five variants
    top/WillFA7.vhd replaces the five copies. What is left per board is variant_pkg.vhd
    with three constants, pins.tcl, device.tcl and WillFA7.sdc.
    The two board differences that were actually structural:
    ROM blocks. Cyclone II has five, everyone else six. rom1..rom5 decode to the same
    addresses on both, so only rom0 and the SD image mapping differ - and that is not
    one block less but a different file format: a five ROM board reads a 10 KByte image
    whose first 2K window goes to 5800h, a six ROM board a 12 KByte image starting at
    5000h. Both wr_rom tables are therefore written out in full rather than derived from
    an offset, so they can be checke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
    [WillFA7.vhd, variant_pkg.vhd]
2026-07-27 Steps 9 and 10: generated .qsf, and the two sound variants move in
    The .qsf is no longer hand maintained. scripts/gen_qsf.ps1 assembles it from
    common_header.tcl (the 22 global assignments that are identical everywhere),
    variants/<n>/device.tcl (family, device, and what else is board specific),
    variants/<n>/pins.tcl, and the file lists in scripts/files_*.tcl. VIRTUAL_PIN comes
    from variant.psd1. That is what stops a new .vhd from being present in one project
    and missing in the other six - the failure mode that made the original shared lib
    idea useless.
    Proof rather than assertion: the generated files were compared assignment by
    assignment against the hand maintained ones. Identical, all fiv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
    [baseline.csv]
2026-07-27 Step 11: release x.21
    One digit changed in rtl/common/version_pkg.vhd, and all five boards follow. That is
    the whole point of the exercise, so it is worth stating plainly: SW_SUB2 went from 0
    to 1 and nothing else was touched.
    bin/Cyclone_II/WillFA7_v121.pof
    bin/Cyclone_IV/FPGA_board_v3.x/willfa7_v221.jic
    bin/Cyclone_IV/FPGA_board_v4.x/willfa7_v321.jic
    bin/cyclone_10/willfa7_v421.jic
    bin/dev_open/willfa7_v521.jic
    Built by scripts/release.ps1, which reads the version out of the sources rather than
    taking it as an argument - a release cannot be filed under a number the FPGA does not
    display. Cyclone II gets a .pof (EPCS4, straight out of the compile), the others a
    .jic via quartus_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
2026-07-27 untrack WillFA7.pin - it is a build report, regenerated by every compile
    It was tracked in the v4 project and survived the git mv in step 1, so one variant
    carried it and the other four did not. .gitignore already covers *.pin.
2026-07-28 Move the repo one level down into FPGA_source/
    N:\Projekte\WillFA7 is the project folder now. The manuals, schematics, Target3001
    files, ROMs, SD images and DEBUG traces that used to live in N:\Projekte\WillFA moved
    in next to the repo, and WillFA11 became a project of its own under N:\Projekte\WillFA11.
    The repo itself - .git included - moved to N:\Projekte\WillFA7\FPGA_source, so none of
    those gigabytes ever land in the working tree and every relative path inside the repo
    keeps working. Nothing under rtl/, top/ or variants/ changed in content.
    PROJECT.md left the repo. It is project metadata full of N: paths, it belongs in the
    project folder one level up, and that is where the overview sc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
2026-07-28 Add WORKFLOW.md: how to work on this repo, IDE included
    The question that prompted it: does the monorepo mean the Quartus IDE is off limits?
    It does not. The IDE stays the normal way to compile, inspect and program, and any
    .vhd under rtl/ or top/ is an ordinary file you can edit in it. What the IDE must not
    decide is assignments - WillFA7.qsf is generated, and the next gen_qsf.ps1 run
    overwrites whatever the Pin Planner or the Assignment Editor put there. The document
    maps each of those cases to the .tcl or .psd1 it belongs in, and recommends
    gen_qsf.ps1 -Check after an IDE session, because Quartus rewrites the .qsf on its own
    for some actions.
    Also written down, because it was only in peo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
2026-07-28 Remeasure the baseline on .21
    scripts/baseline.csv held the .20 figures. It was last written in ef89360, and
    64ec01d ("release x.21") changed SW_SUB2 from x"0" to x"1" without remeasuring, so
    every -Fit run since then reported a drift that had nothing to do with the change
    being checked. A safety net that cries wolf is a safety net nobody reads.
    Measured 28.07.2026 with check.ps1 -Fit, the dormant sound variant separately:
    cyclone_ii 4,313 LE (was 4,312) slack 3.812
    cyclone_iv_v3 5,019 LE (was 5,022) slack 6.171
    cyclone_iv_v4 4,469 LE (was 4,484) slack 6.265
    cyclone_10 4,473 LE (unchanged) slack 6.791
    cyclone_iv_dev_open 4,469 LE (w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
    [baseline.csv]
2026-08-03 Functional level .22 for all seven variants, WillFA7S included
    The sound board variant s_cyclone_iv_v4 was still on its own fork at 6.03 with
    its own top level and a local/ copy of half the common modules. It builds from
    the shared top/WillFA7.vhd now, everything sound specific hangs off HAS_SOUND
    in variant_pkg.vhd. The 6.03 state is kept under archive/s_cyclone_iv_v4_603/.
    Also in here:
    - Cyclone II builds through the shell top/WillFA7_cii.vhd, which declares only
    the 82 ports that board really has. VIRTUAL_PIN needs a subscription license
    and is silently ignored by Quartus 13.0sp1 web edition, so the four optional
    ports used to be placed and driven on real pins. 86 -> 82 pins.
    - W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
    [baseline.csv]
2026-08-04 One SD card format for all variants, CRC check everywhere
    Until .21 there were three card layouts: 10 KByte per game from 5800h on
    Cyclone II, 12 KByte from 5000h on Cyclone IV and Cyclone 10, 64 KByte with
    a CRC16 on WillFA7S. Every board now reads the WillFA7S layout - 128 sectors
    per game from sector 660, game roms in the first 12 KByte, sound board roms
    up to 32 KByte, the expected CRC16-CCITT in the last two bytes of the slot.
    The six 2K windows are the same on every variant now; a five rom board leaves
    window 0 unwritten instead of shifting the other five down. That is what makes
    an old Cyclone II card unusable - and it says so: a .21 card reports error
    code 7 rather than loading a wr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
    [baseline.csv]
2026-08-08 Document why WillFA7S cannot use an EP4CE6
    The claim "not the logic, only the memory" in soundcard_variant.md was
    true at fork level 6.03 (5,392 LE) and has been wrong since .22. The
    variant now sits at 6,377 LE, which is 105 more than an EP4CE6E22C8 has
    at all - so the small device fails on two independent counts, not one.
    New docs/memory_budget_willfa7s.md carries the full arithmetic from the
    fitter report: the M9K breakdown of all six memory groups, the fact that
    ROM alone needs exactly 32 of the 30 available blocks (8,192 usable bits
    per M9K at 8 bit width, the ninth column is parity), and the options that
    were checked and rejected - parallel SRAM (28 pins needed, 10 free), QSPI
    PSRAM (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
2026-10-16 WillFA7S: game ROMs from the configuration flash when no SD card answers
    New rtl/common/Flash_ROM.vhd reads the first 32 KByte of a game slot from the
    EPCS16 (game n at 080000h + n * 8000h) and takes over the ROM write port,
    boot_phase(2) and the error LED. It starts when SD_Card ends in error 1..4
    (new output o_no_card); errors 5..7 (card present, data bad) do not fall back.
    No CRC in the flash, only a check against an empty slot (reset vector FFFF ->
    error 8). Flash boot shows the build date instead of the two checksums.
    Only s_cyclone_iv_v4 has HAS_FLASH_ROM = true, as a hardware test. The other
    boards carry the four FLASH_* ports as VIRTUAL_PIN (Cyclone II: open in the
    shell) and synthe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
2026-10-16 x.30: back to the x.20 SD card for every board, sound roms in a second area
    Every board reads the x.20 Cyclone IV card again: 12 KByte per game, 24
    sectors from sector 660, no CRC (SD_CHECK_CRC false everywhere). Cyclone II
    reads the same card and drops window 0, so one image serves all boards and an
    x.20 Cyclone IV card runs unchanged on every board without a sound board.
    The WillFA7S sound board roms move to a second area of the card, 20 KByte per
    game from sector 1428 = 660 + 32 * 24. SD_Card.vhd v13 reads it in a second
    CMD18 pass (generics Sound_*, HAS_SOUND only) after a 100 ms pause for the R1b
    busy of CMD12. The flash slot keeps MPU and sound roms together;
    make_flash_hex.ps1 now as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
2026-10-20 Blanking doc: differences between Cyclone II boards v0.5, 1.0.22 and 1.3.0
2026-10-21 Release x.30 for the other five boards, flash fallback on every EPCS16 board
    HAS_FLASH_ROM is switched on for cyclone_iv_v3, cyclone_iv_v4, cyclone_10 and
    cyclone_iv_dev_open: FLASH_* placed on the configuration pins (E22/E144 12/13/8/6,
    F17 H1/H2/D2/C1, both checked against the Quartus pin report), the four pins released
    as regular I/O in device.tcl, a willfa7_roms.cof per variant. Cyclone II keeps none -
    it has an EPCS4.
    bin/: 1.30 .pof, 2.30, 3.30, 4.30 and 5.30 .jic, all without game roms. The local
    *_roms.jic next to them is git ignored.
    Baseline remeasured: +157..+190 LE for Flash_ROM on the four boards, all with
    positive slack. Untested in hardware on every board, the flash fallback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
2026-10-21 Cyclone II: game roms from the EPCS4, 1.30 replaced
    The EPCS4 has no room for the 32 KByte slots, so the board with ROM_COUNT = 5 uses a
    compact layout: 10 KByte per game (ROM 0800h-2FFFh) from 030000h, 32 games end at
    07FFFFh. FL_BASE/FL_SLOT/FL_FIRST/FL_BYTES in top/WillFA7.vhd follow ROM_COUNT;
    make_flash_hex.ps1 -CycloneII writes that layout.
    DCLK and DATA0 have no user I/O on Cyclone II, so WillFA7_cii.vhd reaches the flash
    through the cycloneii_asmiblock hard macro (oe active low, as in Altera's EPCS
    controller), declared as a local component because Quartus 22.1 has no cycloneii
    library and the shell is in every file list.
    Flash_ROM v02: generic First_Addr, waiting and blinking in 2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
2026-10-21 Hardware test 1.30 Cyclone II: boot from the flash without SD card, game 17
    Partial test, passed 21.10.2026: ASMI block reads, the bitstream stays at 0 after
    programming the rom .jic, the compact slot address above game 0 is right, and the
    bit order of the rom data is confirmed. Everything else on the list is still open.
2026-10-23 User manuals as HTML, WillFA7 updated to x.30
    - WillFA7_HWv1_x_user_manual.html: new chapters "Running without SD card"
    (error 8) and "Game roms in the FPGA flash" (EPCS16 layout, compact EPCS4
    layout on Cyclone II, make_flash_hex.ps1 / quartus_cpf), board variant table
    - WillFA7S_HWv1_x_user_manual.html: 6.30 as before, broken error table row fixed,
    links to the WillFA7 manual
    - single self-contained files, images embedded as JPEG
2026-10-23 docs/index.html: landing page for GitHub Pages linking the user manuals
2026-10-23 index.html generated from the manuals, description per manual
    Every manual carries <meta name=description> now; make_index.ps1 builds the landing page from the manuals in docs/ (title, language, description).
